karamakil08/Ahrar-Flight-Controller/Schematics SS/Connectors.jpg

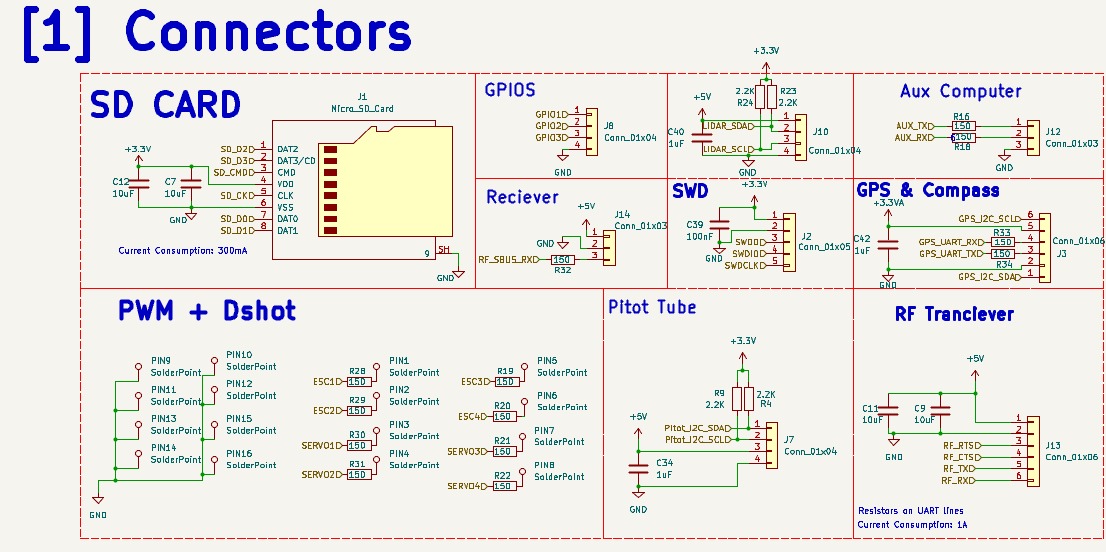
Schematics SS/Connectors.jpg
