karamakil08/Ahrar-Flight-Controller/Schematics SS/MCU.jpg

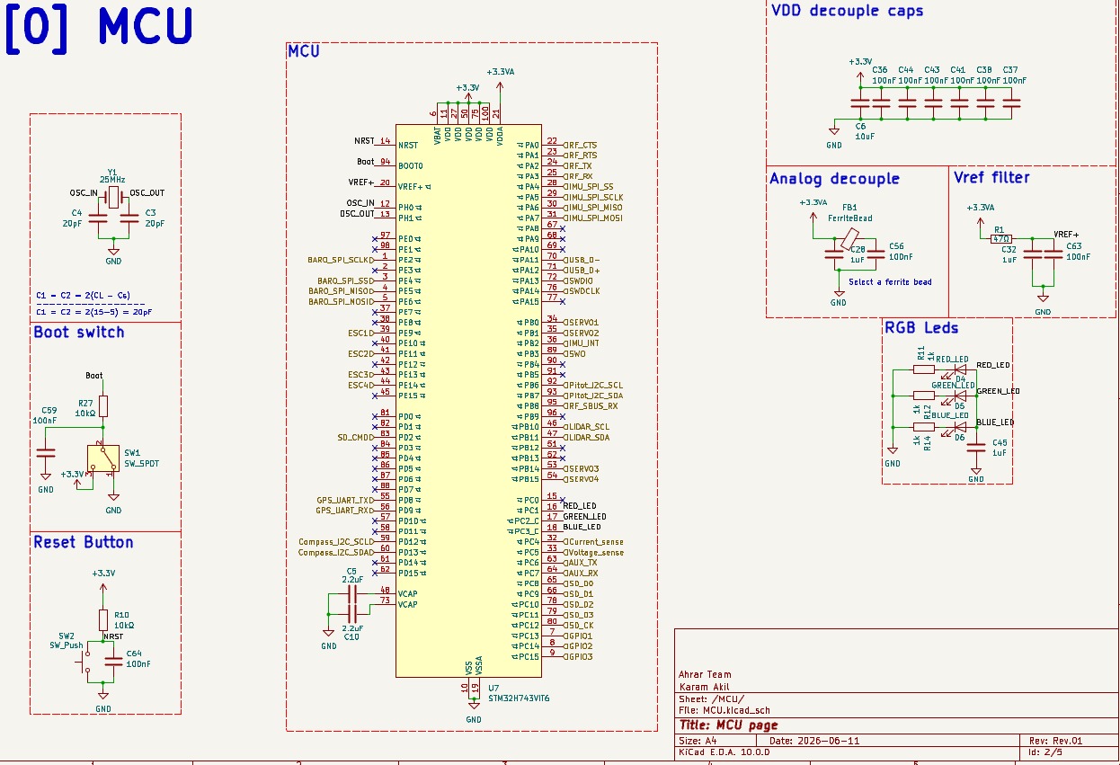
Schematics SS/MCU.jpg
