karamakil08/Ahrar-Flight-Controller/Schematics SS/Power.jpg

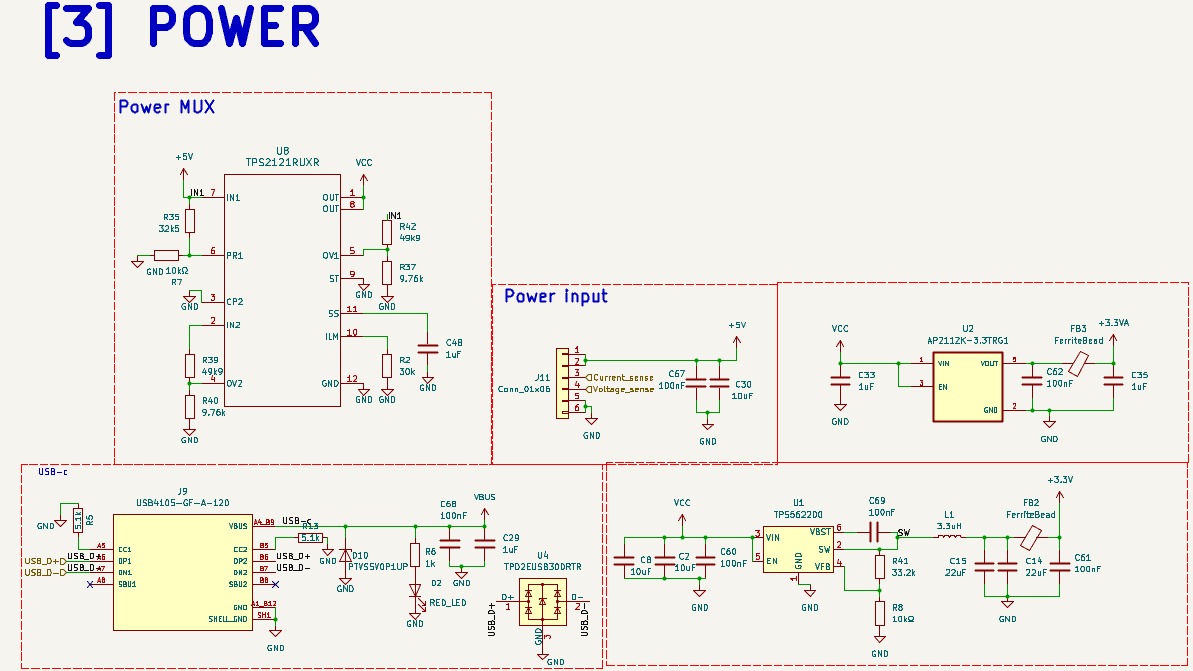
Schematics SS/Power.jpg
