karamakil08/Ahrar-Flight-Controller/Schematics SS/Sensors.jpg

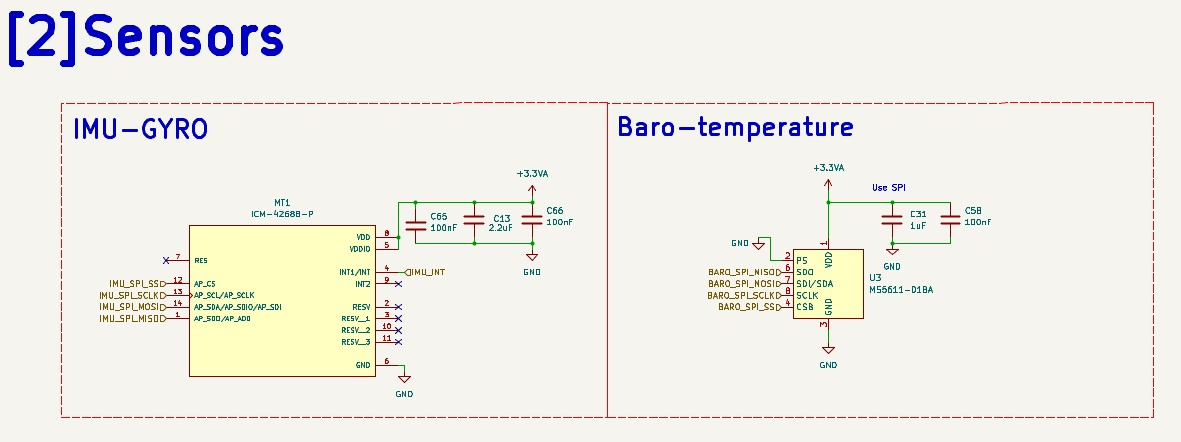
Schematics SS/Sensors.jpg
