karamakil08/Ahrar-Flight-Controller/Ahrar Flight Controller/Ahrar Flight Controller.csv

Reference | Value | Datasheet | Footprint | Qty | DNP | Part Number | Distributer Link | Price
C1,C3 | 6pF | https://cdn.ozdisan.com/public/product/assets/UPY-GP_NP0_16V-to-50V_18.pdf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 | Capacitor_SMD:C_0402_1005Metric | 2 |  | CC0402DRNPO9BN6R0 | https://www.ozdisan.com/p/smt-smd-ve-mlcc-kapasitorler-184/yageo-cc0402drnpo9bn6r0-746529?catSequenceId=184
C4,C16 | 10pF | https://cdn.ozdisan.com/public/product/assets/UPY-GP_NP0_16V-to-50V_18.pdf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 | Capacitor_SMD:C_0603_1608Metric | 2 |  | CL10C100JB81PNC | https://www.ozdisan.com/p/smt-smd-ve-mlcc-kapasitorler-184/samsung-cl10c100jb81pnc-522432?catSequenceId=184
C5,C10,C17,C18,C19,C20,C21,C22,C28,C30,C31 | 2.2uF | https://cdn.ozdisan.com/public/product/assets/SAMSUNG%20MLCC_JAN-2024.pdf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 | Capacitor_SMD:C_0603_1608Metric | 11 |  | CL10B225KP8NNNC | https://www.ozdisan.com/p/smt-smd-ve-mlcc-kapasitorler-184/samsung-cl10b225kp8nnnc-359581?catSequenceId=184
C6,C7,C8,C9,C11,C23,C24,C27,C29 | 22uF | https://cdn.ozdisan.com/public/product/assets/SAMSUNG%20MLCC_JAN-2024.pdf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 | Capacitor_SMD:C_0805_2012Metric | 9 |  | CL21A226KOQNNNE | https://www.ozdisan.com/p/smt-smd-ve-mlcc-kapasitorler-184/samsung-cl21a226koqnnne-399002
C13 | 2.2uF | https://cdn.ozdisan.com/public/product/assets/Murata_GRM_MLCC.pdf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 | Capacitor_SMD:C_0402_1005Metric | 1 |  | GRT155C81A225ME13D | https://www.ozdisan.com/p/smt-smd-ve-mlcc-kapasitorler-184/murata-grt155c81a225me13d-624222
C25,C26 | 100uF | https://cdn.ozdisan.com/public/product/assets/VISHAY-293D%20SERIES.pdf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 | Capacitor_Tantalum_SMD:CP_EIA-6032-20_AVX-F | 2 |  | 293D107X0010C2TE3 | https://www.ozdisan.com/p/tantal-kapasitorler-178/vishay-293d107x0010c2te3-502187
C36,C37,C38,C39,C40,C41,C43,C44,C45,C47,C49,C50,C51,C52,C56,C57,C58,C59,C63,C64,C65,C66,C67,C68,C69,C70,C71,C72,C73,C74,C75 | 100nF | https://cdn.ozdisan.com/public/product/assets/Murata_GRM_MLCC.pdf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 | Capacitor_SMD:C_0402_1005Metric | 31 |  | GRM155R71C104KA88D | https://www.ozdisan.com/p/smt-smd-ve-mlcc-kapasitorler-184/murata-grm155r71c104ka88d-423396
D2 | Green LED | https://cdn.ozdisan.com/public/product/assets/HL-PST-1608U51GC-yeni.PDF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 | LED_SMD:LED_0603_1608Metric | 1 |  | HL-PST-1608U51GC | https://www.ozdisan.com/p/sinyal-ledler-tek-renkli-361/honglitronic-hl-pst-1608u51gc-471660
D3 | ESD321DYAR | https://www.onsemi.com/pdf/datasheet/esd5z2.5t1-d.pdf | Diode_SMD:D_SOD-523 | 1 |  | ESD321DYAR | https://www.mouser.com.tr/en/ProductDetail/Texas-Instruments/ESD321DYAR?qs=rQFj71Wb1eXoYwRMra0IYA%3D%3D
D4 | RED_LED | https://cdn.ozdisan.com/public/product/assets/27-21-R6C-AP1Q2B-3C.PDF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 | LED_SMD:LED_0603_1608Metric | 1 |  | 27-21/R6C-AP1Q2B/3C | https://www.ozdisan.com/p/sinyal-ledler-tek-renkli-361/everlight-27-21-r6c-ap1q2b-3c-602569
D6 | BLUE_LED | https://cdn.ozdisan.com/public/product/assets/HL-PST-1608H203BC-yeni.PDF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 | LED_SMD:LED_0603_1608Metric | 1 |  | HL-PST-1608H203BC | https://www.ozdisan.com/p/sinyal-ledler-tek-renkli-361/honglitronic-hl-pst-1608h203bc-471659
FB1 | FerriteBead | https://www.murata.com/en-us/products/productdata/8796741599262/ENFA0004.pdf | Resistor_SMD:R_0603_1608Metric | 1 |  | BLM18HE601SN1D | https://www.e-komponent.com/blm18he601sn1d-murata-electronics-ferit-bead-ve-cip
J1 | Conn_02x08_Counter_Clockwise | https://cdn.ozdisan.com/public/product/assets/DS1022-REV.pdf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 | Connector_PinHeader_2.54mm:PinHeader_2x08_P2.54mm_Horizontal | 1 |  | DS1022-2X8RF11-B | https://www.ozdisan.com/p/pin-headerlar-293/connfly-ds1022-2x8rf11-b-699898?catSequenceId=293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
J2 | Conn_01x04 | https://www.molex.com/en-us/products/part-detail/22284046?display=pdf | Connector_PinHeader_2.54mm:PinHeader_1x04_P2.54mm_Vertical | 1 |  | 22-28-4046 | https://www.mouser.com.tr/en/ProductDetail/Molex/22-28-4046?qs=GAPJcf4kvdtZsXSzVDpHFw%3D%3D
J3 | Conn_01x06 | https://www.jst-mfg.com/product/pdf/eng/eGH.pdf | Connector_JST:JST_GH_SM06B-GHS-TB_1x06-1MP_P1.25mm_Horizontal | 1 |  | SM06B-GHS-TB | https://www.e-komponent.com/connector-header-sm06b-ghs-tb
J4 | 1040310811 | https://www.molex.com/en-us/products/part-detail-pdf/1040310811?display=pdf | Molex 1040310811:104031-0811_MOL | 1 |  | MOLEX-1040310811 | https://www.mouser.com.tr/en/ProductDetail/Molex/104031-0811?qs=udsGRKD4nA3Tvy7wqky%252BuA%3D%3D
J9 | USB4105-GF-A-120 | https://www.mouser.com/catalog/specsheets/Global_Connector_Technology_usb4105.pdf | USB4105-GF-A-120:GCT_USB4105-GF-A-120 | 1 |  | USB4105-GF-A-120 | https://www.mouser.com.tr/en/ProductDetail/GCT/USB4105-GF-A-120?qs=QNEnbhJQKva%252Bjxw%2FpEjDhQ%3D%3D
J10,J15,J16 | Conn_01x04 | https://www.mouser.com.tr/datasheet/3/1070/1/eGH.pdf | Connector_JST:JST_GH_SM04B-GHS-TB_1x04-1MP_P1.25mm_Horizontal | 3 |  | SM04B-GHS-TB(LF)(SN) | https://www.mouser.com.tr/en/ProductDetail/JST-Commercial/SM04B-GHS-TBLFSN?qs=QpmGXVUTftGayLYZQBIuZw%3D%3D
J13,J17 | Conn_01x06 | https://www.molex.com/en-us/products/part-detail-pdf/5024940670?display=pdf | Connector_Molex:Molex_CLIK-Mate_502494-0670_1x06-1MP_P2.00mm_Horizontal | 2 |  | 502494-0670 | https://www.mouser.com.tr/en/ProductDetail/Molex/502494-0670?qs=zRnNmUVysJflJNy8qKc1Eg%3D%3D
J14,J18 | Conn_01x03 | https://www.mouser.com.tr/datasheet/3/1070/1/eGH.pdf | Connector_JST:JST_GH_SM03B-GHS-TB_1x03-1MP_P1.25mm_Horizontal | 2 |  | SM03B-GHS-TB(LF)(SN) | https://www.mouser.com.tr/en/ProductDetail/JST-Commercial/SM03B-GHS-TBLFSN?qs=QpmGXVUTftFwNjadUkntHA%3D%3D
MT1 | ICM-42688-P | https://product.tdk.com/system/files/dam/doc/product/sensor/mortion-inertial/imu/data_sheet/ds-000347-icm-42688-p-v1.6.pdf | ICM_42688_P:LGA14_2P5X3X0P91_TDK-L | 1 |  | ICM-42688-P | https://www.mouser.com.tr/en/ProductDetail/TDK-InvenSense/ICM-42688-P?qs=OlC7AqGiEDk8QrNAV728zw%3D%3D
MT2 | ICM-45686 | https://www.mouser.com/catalog/specsheets/TDK_DS_000577_ICM_45686.pdf | ICM_42688_P:LGA14_2P5X3X0P91_TDK-L | 1 |  | ICM-45686 | https://www.mouser.com.tr/en/ProductDetail/TDK-InvenSense/ICM-45686?qs=vvQtp7zwQdPk96IFOwypvQ%3D%3D
R2,R23 | 30k | https://cdn.ozdisan.com/public/product/assets/Pansonic_Anti-Sulfurated%20Thick%20Film%20Chip%20Resistors_ERJ-S%2CS02%2CS03%2CS06%2CS08%2CS14%2CS12%2CS1D%2CS1T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 | Resistor_SMD:R_0402_1005Metric | 2 |  | ERJ2RKF3002X | https://www.ozdisan.com/p/smt-smd-ve-cip-direncler-194/panasoniceurope-erj2rkf3002x-614685?s=ERJ2RKF3002X
R3,R12,R17,R24,R25,R26,R27,R38,R43,R44,R47,R48,R49,R52,R57,R59,R60,R64,R65,R66,R73,R74,R75,R76,R79,R80,R81,R82 | 20 | https://cdn.ozdisan.com/public/product/assets/Pansonic_Anti-Sulfurated%20Thick%20Film%20Chip%20Resistors_ERJ-S%2CS02%2CS03%2CS06%2CS08%2CS14%2CS12%2CS1D%2CS1T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 | Resistor_SMD:R_0402_1005Metric | 28 |  | ERJ2GEJ200X | https://www.ozdisan.com/p/smt-smd-ve-cip-direncler-194/panasoniceurope-erj2gej200x-1182780?catSequenceId=194
R4,R9 | 4.7 | https://cdn.ozdisan.com/public/product/assets/AECQ200CQ_ROYALOHM.pdf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 | Resistor_SMD:R_0402_1005Metric | 2 |  | CQ02WGJ047JTCE | https://www.ozdisan.com/p/smt-smd-ve-cip-direncler-194/royalohm-cq02wgj047jtce-587859?catSequenceId=194
R5,R13 | 5.1k | https://cdn.ozdisan.com/public/product/assets/Pansonic_Anti-Sulfurated%20Thick%20Film%20Chip%20Resistors_ERJ-S%2CS02%2CS03%2CS06%2CS08%2CS14%2CS12%2CS1D%2CS1T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 | Resistor_SMD:R_0402_1005Metric | 2 |  | ERJ2RKF5101X | https://www.ozdisan.com/p/smt-smd-ve-cip-direncler-194/panasoniceurope-erj2rkf5101x-1046672
R6,R14,R83 | 1k | https://cdn.ozdisan.com/public/product/assets/general_royalohm.pdf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 | Resistor_SMD:R_0402_1005Metric | 3 |  | 0402WGJ0102TCE | https://www.ozdisan.com/p/smt-smd-ve-cip-direncler-194/royalohm-0402wgj0102tce-431887?catSequenceId=194
R10,R15,R36,R41,R45,R46,R50,R51,R53,R54,R55 | 10kΩ | http://cdn.ozdisan.com/public/product/assets/Pansonic_Anti-Sulfurated%20Thick%20Film%20Chip%20Resistors_ERJ-S%2CS02%2CS03%2CS06%2CS08%2CS14%2CS12%2CS1D%2CS1T%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 | Resistor_SMD:R_0402_1005Metric | 11 |  | ERJ2RKF1002X | https://www.ozdisan.com/p/smt-smd-ve-cip-direncler-194/panasoniceurope-erj2rkf1002x-609851?catSequenceId=194
R16,R18,R19,R20,R21,R22,R28,R29,R30,R31,R32,R33,R34,R56,R58,R61,R62,R63,R77,R78 | 220 | https://cdn.ozdisan.com/public/product/assets/Pansonic_Anti-Sulfurated%20Thick%20Film%20Chip%20Resistors_ERJ-S%2CS02%2CS03%2CS06%2CS08%2CS14%2CS12%2CS1D%2CS1T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 | Resistor_SMD:R_0402_1005Metric | 20 |  | ERJ2RKF2200X | https://www.ozdisan.com/p/smt-smd-ve-cip-direncler-194/panasoniceurope-erj2rkf2200x-621350?catSequenceId=194
R35 | 32k5 | https://cdn.ozdisan.com/public/product/assets/general_royalohm.pdf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 | Resistor_SMD:R_0402_1005Metric | 1 |  | 0402WGF3242TCE | https://www.ozdisan.com/p/smt-smd-ve-cip-direncler-194/royalohm-0402wgf3242tce-506352
R37,R40 | 9.76k | https://cdn.ozdisan.com/public/product/assets/general_royalohm.pdf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 | Resistor_SMD:R_0402_1005Metric | 2 |  | 0402WGF9761TCE | https://www.ozdisan.com/p/smt-smd-ve-cip-direncler-194/royalohm-0402wgf9761tce-506310
R39,R42 | 49k9 | https://cdn.ozdisan.com/public/product/assets/Pansonic_Anti-Sulfurated%20Thick%20Film%20Chip%20Resistors_ERJ-S%2CS02%2CS03%2CS06%2CS08%2CS14%2CS12%2CS1D%2CS1T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 | Resistor_SMD:R_0402_1005Metric | 2 |  | ERJ2RKF4992X | https://www.ozdisan.com/p/smt-smd-ve-cip-direncler-194/panasoniceurope-erj2rkf4992x-621356
R67,R68,R69,R70,R71,R72 | 4.7k | https://cdn.ozdisan.com/public/product/assets/Pansonic_Anti-Sulfurated%20Thick%20Film%20Chip%20Resistors_ERJ-S%2CS02%2CS03%2CS06%2CS08%2CS14%2CS12%2CS1D%2CS1T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 | Resistor_SMD:R_0402_1005Metric | 6 |  | ERJ2RKF4701X | https://www.ozdisan.com/p/smt-smd-ve-cip-direncler-194/panasoniceurope-erj2rkf4701x-494668?catSequenceId=194
SW1 | SW_SPDT | https://cdn.ozdisan.com/public/product/assets/L-KLS7-MSK-12C03.pdf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 | Button_Switch_SMD:SW_SPDT_CK_JS102011SAQN | 1 |  | L-KLS7-MSK-12C03 | https://www.ozdisan.com/p/surgulu-sivicler-495/kls-electronic-l-kls7-msk-12c03-518011
SW2 | SW_Push | https://cdn.ozdisan.com/public/product/assets/PTS810-seri-CK.pdf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 | Button_Switch_SMD:SW_SPST_PTS810 | 1 |  | PTS810 SJM 250 SMTR LFS | https://www.ozdisan.com/p/tact-sivicler-485/littelfuse-ck-pts810-sjm-250-smtr-lfs-478609?catSequenceId=485
U2 | TLV1117-33 | http://www.ti.com/lit/ds/symlink/tlv1117.pdf | Package_SON:WSON-8-1EP_4x4mm_P0.8mm_EP2.2x3mm | 1 |  | TLV1117-33IDRJR | https://www.mouser.com.tr/en/ProductDetail/Texas-Instruments/TLV1117-33IDRJR?qs=p6lVfQR1GSoDjhibbRLWxw%3D%3D
U3 | MS5611-01BA | https://www.te.com/commerce/DocumentDelivery/DDEController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 | Package_LGA:LGA-8_3x5mm_P1.25mm | 1 |  | MS561101BA03-50 | https://www.mouser.com.tr/en/ProductDetail/TE-Connectivity-Measurement-Specialties/MS561101BA03-50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
U4 | TPD2EUSB30DRTR | http://www.ti.com/lit/ds/symlink/tpd2eusb30a.pdf | Package_TO_SOT_SMD:Texas_DRT-3 | 1 |  | TPD2EUSB30DRTR | https://www.mouser.com.tr/en/ProductDetail/Texas-Instruments/TPD2EUSB30DRTR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
U5 | BMP581 | https://www.bosch-sensortec.com/media/boschsensortec/downloads/datasheets/bst-bmp581-ds004.pdf | BMP581:BMP581 | 1 |  | BMP581 | https://www.mouser.com.tr/en/ProductDetail/Bosch-Sensortec/BMP581?qs=Li%252BoUPsLEntPL9tlFmcgXg%3D%3D
U7 | STM32H743VIT6 | https://www.st.com/resource/en/datasheet/stm32h743vi.pdf | Package_QFP:LQFP-100_14x14mm_P0.5mm | 1 |  | STM32H743VIT6 | https://www.mouser.com.tr/en/ProductDetail/STMicroelectronics/STM32H743VIT6?qs=FNcb6ahWXRw0Me5k2ZHgWw%3D%3D
U8 | TPS2121 | https://www.ti.com/lit/gpn/tps2121 | footprints.ugly:RUX0012A | 1 |  | TPS2121RUXR | https://www.mouser.com.tr/en/ProductDetail/Texas-Instruments/TPS2121RUXR?qs=qSfuJ%252Bfl%2Fd7dCYiVnUfngQ%3D%3D
Y1 | 25MHz | https://cdn.ozdisan.com/public/product/assets/ECS_ECX-2236Q.pdf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 | Oscillator:Oscillator_SMD_Abracon_ASDMB-4Pin_2.5x2.0mm | 1 |  | ECS-250-10-36Q-ES-TR | https://www.ozdisan.com/p/kristaller-508/ecs-ecs-250-10-36q-es-tr-710745?catSequenceId=508
Y2 | 32.768KHz | https://cdn.ozdisan.com/public/product/assets/RT2012_SERIES.pdf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 | Crystal:Crystal_SMD_2012-2Pin_2.0x1.2mm_HandSoldering | 1 |  | RT2012-32.768-7-TR | https://www.ozdisan.com/p/kristaller-508/raltron-rt2012-32-768-7-tr-994638?catSequenceId=508
