karamakil08/Ahrar-Flight-Controller/Ahrar Flight Controller/Footprints and 3D models/3D models/USB4105-GF-A-120.step

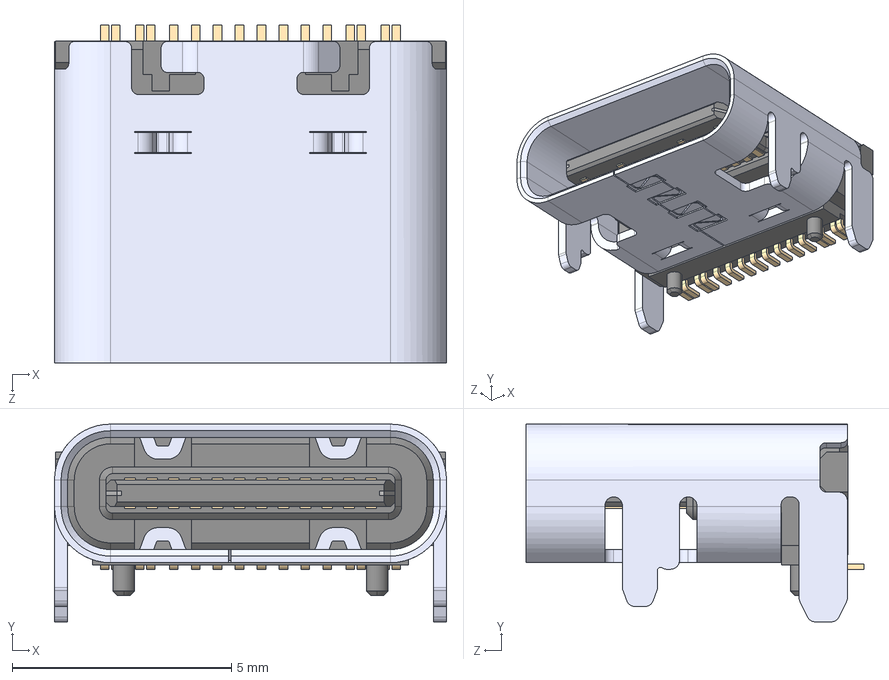
[picture p5: CAD file, 2026-08-06]
Ahrar Flight Controller/Footprints and 3D models/3D models/USB4105-GF-A-120.step
8.94 x 4.51 x 7.71 mm
