karamakil08/Ahrar-Flight-Controller/Ahrar Flight Controller/Footprints and 3D models/3D models/HSE_Oscillator.STEP

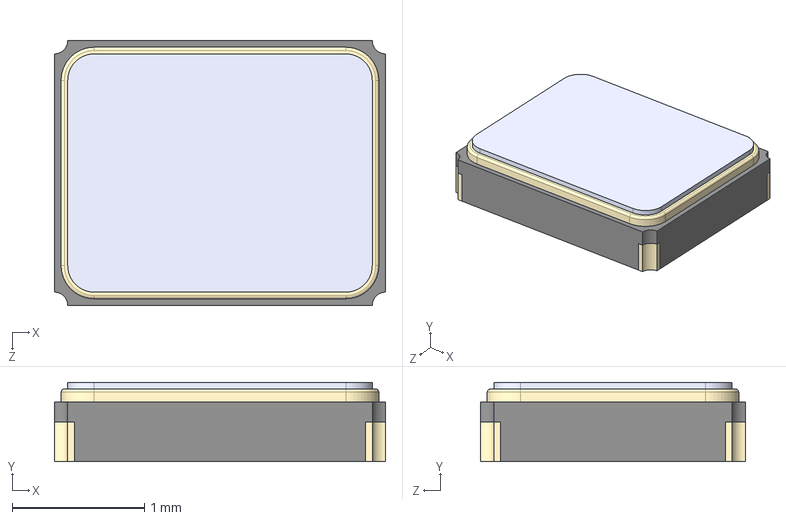
[picture p6: CAD file, 2026-08-06]
Ahrar Flight Controller/Footprints and 3D models/3D models/HSE_Oscillator.STEP
2.50 x 0.6 x 2.00 mm
