karamakil08/Ahrar-Flight-Controller/Ahrar Flight Controller/Footprints and 3D models/3D models/BMP581.step

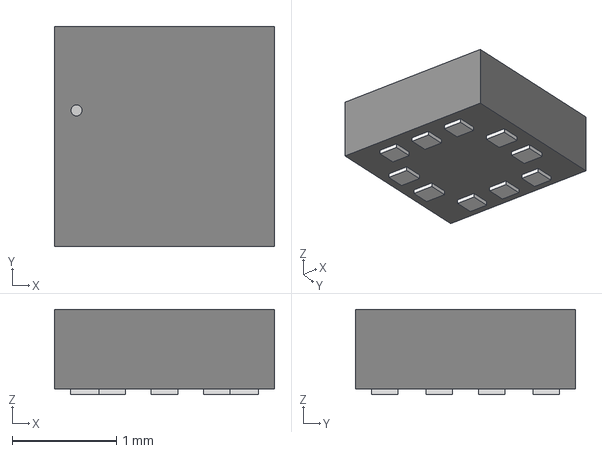
[picture p7: CAD file, 2026-08-06]
Ahrar Flight Controller/Footprints and 3D models/3D models/BMP581.step
2.11 x 2.11 x 0.815 mm
