karamakil08/Ahrar-Flight-Controller/Ahrar Flight Controller/Footprints and 3D models/3D models/LSE_Oscillator.STEP

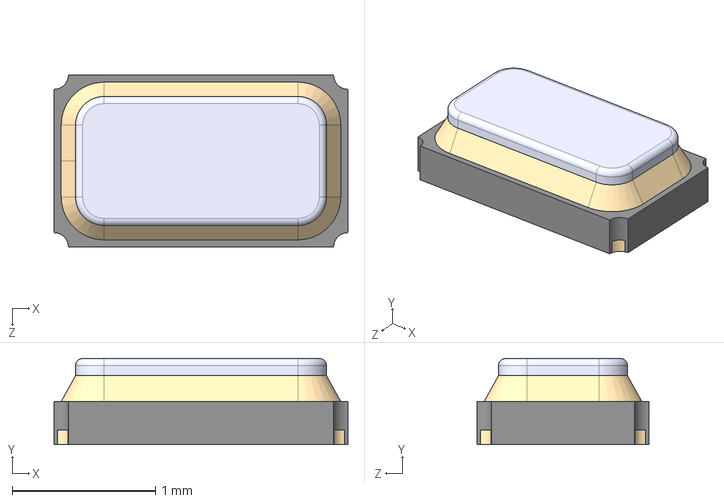
[picture p8: CAD file, 2026-08-06]
Ahrar Flight Controller/Footprints and 3D models/3D models/LSE_Oscillator.STEP
2.05 x 0.6 x 1.20 mm
