karamakil08/Ahrar-Flight-Controller/Ahrar Flight Controller/Footprints and 3D models/3D models/SD-card socket.stp

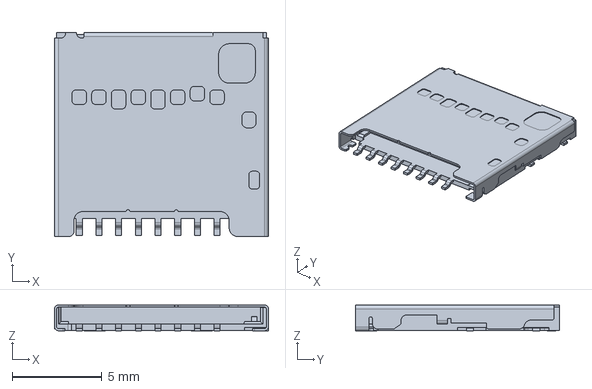
[picture p9: CAD file, 2026-08-06]
Ahrar Flight Controller/Footprints and 3D models/3D models/SD-card socket.stp
11.9 x 11.4 x 1.45 mm
