karamakil08/Ahrar-Flight-Controller/Ahrar Flight Controller/Footprints and 3D models/3D models/TPS2121RUXR.STEP

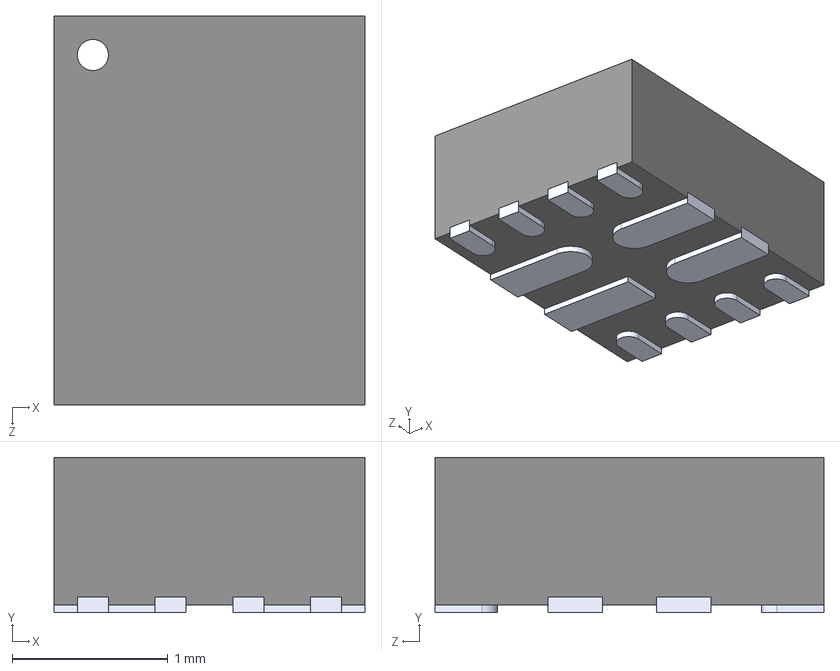
[picture p10: CAD file, 2026-08-06]
Ahrar Flight Controller/Footprints and 3D models/3D models/TPS2121RUXR.STEP
2.00 x 1.00 x 2.50 mm
