karamakil08/Ahrar-Flight-Controller/Ahrar Flight Controller/Footprints and 3D models/3D models/ICM-45686.STEP

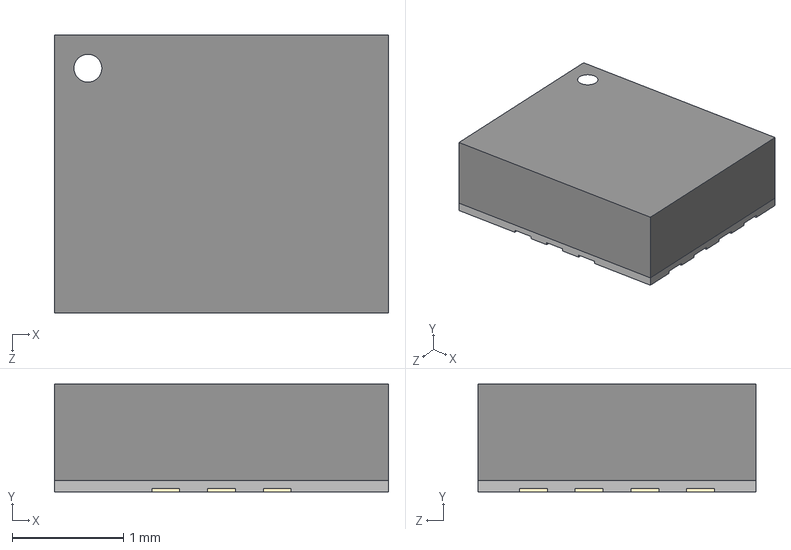
[picture p11: CAD file, 2026-08-06]
Ahrar Flight Controller/Footprints and 3D models/3D models/ICM-45686.STEP
3.00 x 0.97 x 2.50 mm
