karamakil08/Ahrar-Flight-Controller/Ahrar Flight Controller/Footprints and 3D models/3D models/TLV1117-33.stp

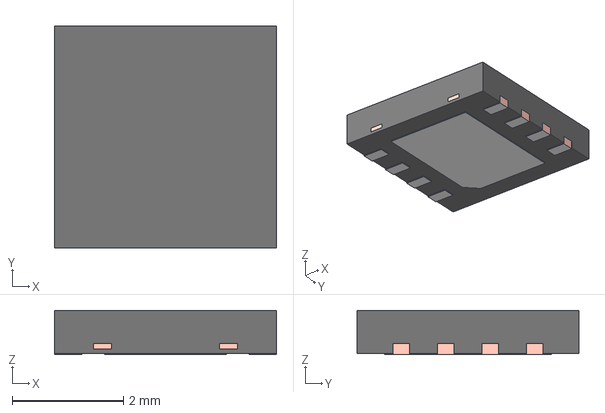
[picture p12: CAD file, 2026-08-06]
Ahrar Flight Controller/Footprints and 3D models/3D models/TLV1117-33.stp
4.00 x 4.00 x 0.8 mm
FRAME
