karamakil08/Ahrar-Flight-Controller/Ahrar Flight Controller/Footprints and 3D models/3D models/SPDT switch.STEP

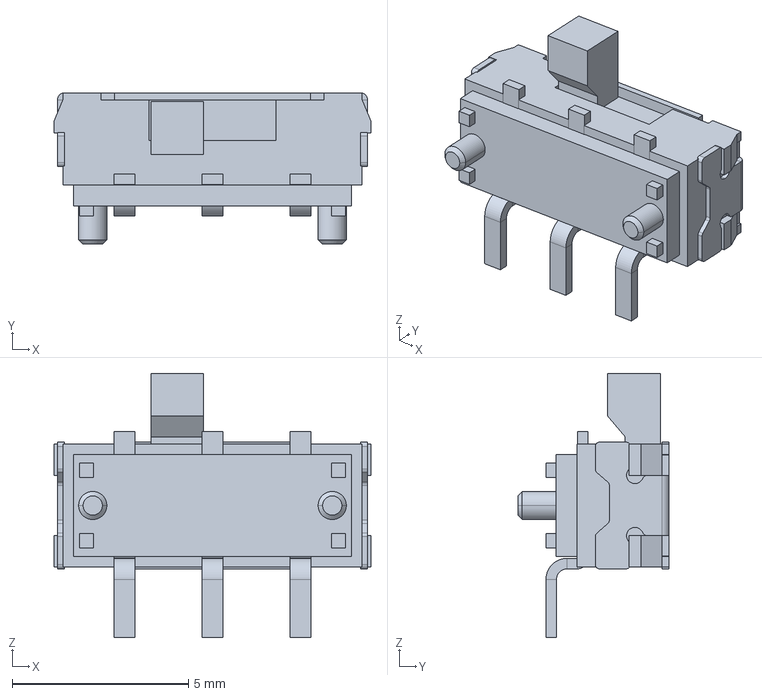
[picture p13: CAD file, 2026-08-06]
Ahrar Flight Controller/Footprints and 3D models/3D models/SPDT switch.STEP
9.00 x 4.30 x 7.50 mm
