karamakil08/Ahrar-Flight-Controller/Ahrar Flight Controller/Footprints and 3D models/3D models/5024940670.stp

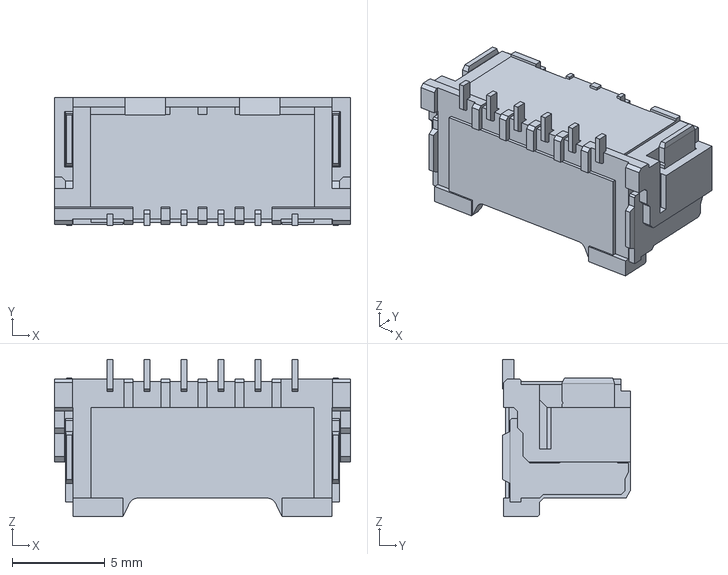
[picture p14: CAD file, 2026-08-06]
Ahrar Flight Controller/Footprints and 3D models/3D models/5024940670.stp
16.0 x 6.90 x 8.50 mm
