karamakil08/Ahrar-Flight-Controller/Ahrar Flight Controller/Ahrar Flight Controller.kicad_pcb

## KiCad design Ahrar Flight Controller/Ahrar Flight Controller.kicad_pcb (2026-08-07)

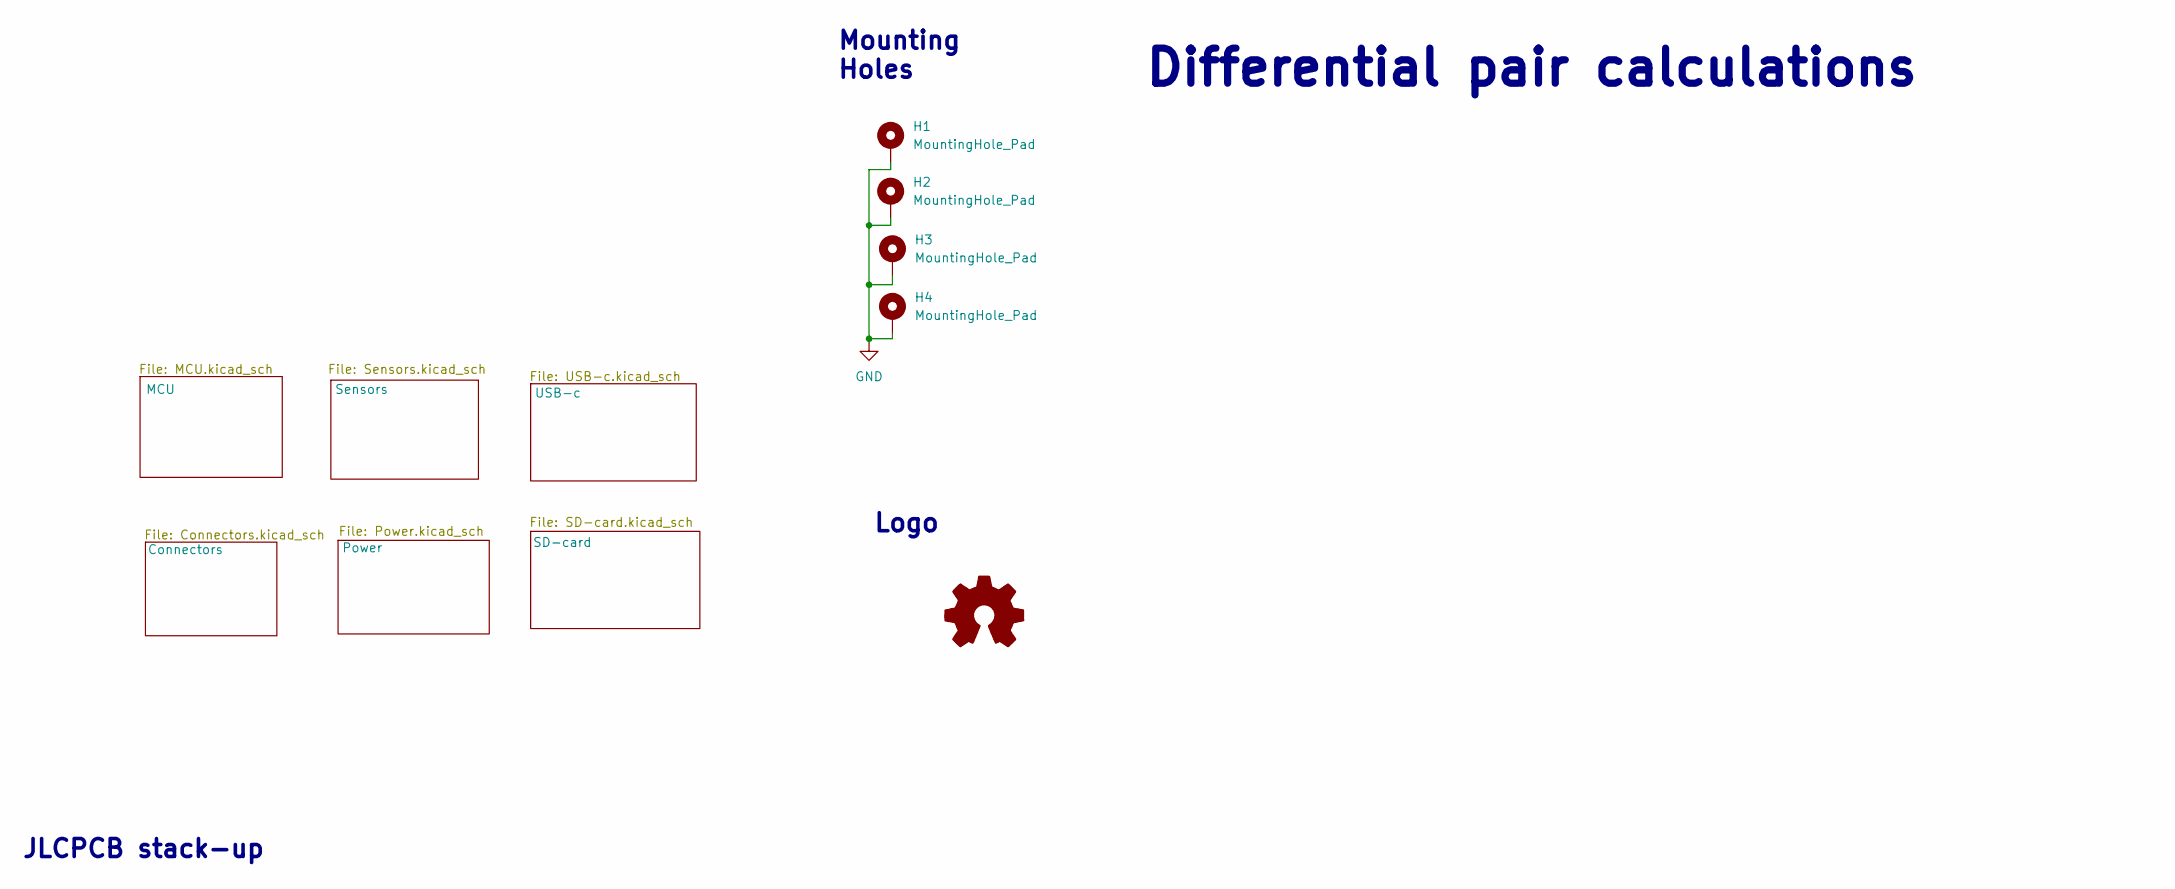
[picture p15: schematic Ahrar Flight Controller.kicad_sch]

Parts:
H1, H2, H3, H4: MountingHole_Pad; MountingHole_2.2mm_M2_Pad_Via
Logo1: Hananou logo

Connections:
GND: H1.1 (1_1), H2.1 (1_1), H3.1 (1_1), H4.1 (1_1); also elsewhere on the board

Notes on the sheet:
Differential pair calculations
Mounting Holes
JLCPCB stack-up
Logo

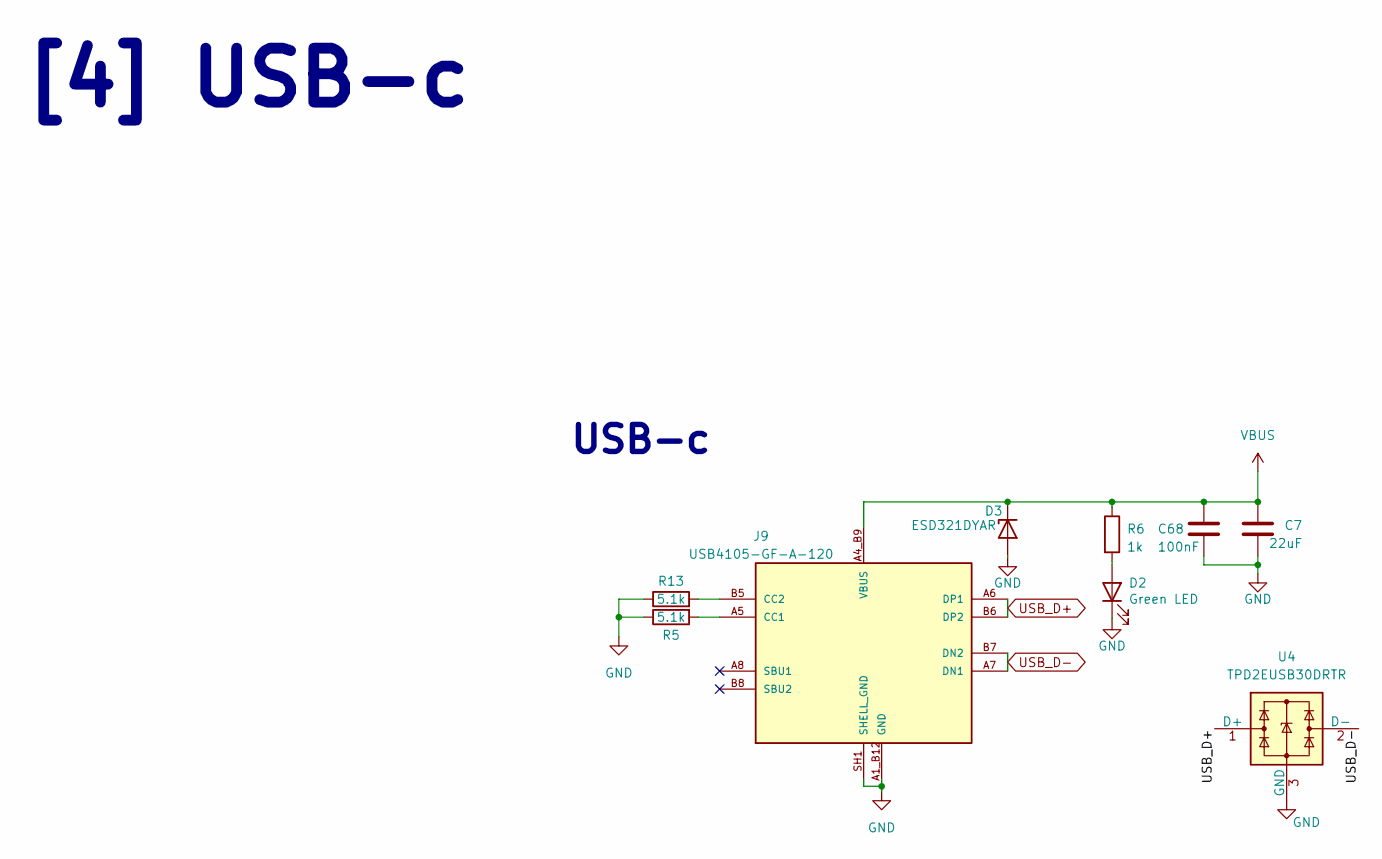
[picture p16: schematic USB-c.kicad_sch, USB-c]

Parts:
C7: 22uF; C_0805_2012Metric; Part Number CL21A226KOQNNNE
C68: 100nF; C_0402_1005Metric; Part Number GRM155R71C104KA88D
D2: Green LED; LED_0603_1608Metric; Part Number HL-PST-1608U51GC
D3: ESD321DYAR; D_SOD-523; Part Number ESD321DYAR
J9: USB4105-GF-A-120; GCT_USB4105-GF-A-120; Part Number USB4105-GF-A-120
R5, R13: 5.1k; R_0402_1005Metric; Part Number ERJ2RKF5101X
R6: 1k; R_0402_1005Metric; Part Number 0402WGJ0102TCE
U4: TPD2EUSB30DRTR; Texas_DRT-3

Connections:
GND: C7.2, C68.2, D2.1 (K), D3.2 (A), J9.A1_B12 (GND), J9.B1_A12 (GND), J9.SH1 (SHELL_GND), J9.SH2 (SHELL_GND), J9.SH3 (SHELL_GND), J9.SH4 (SHELL_GND), R5.1, R13.1, U4.3 (GND); also elsewhere on the board
unnamed: D2.2 (A), R6.2
unnamed: J9.A5 (CC1), R5.2
unnamed: J9.B5 (CC2), R13.2
USB_D+: J9.A6 (DP1), J9.B6 (DP2), U4.1 (D+); also elsewhere on the board
USB_D-: J9.A7 (DN1), J9.B7 (DN2), U4.2 (D-); also elsewhere on the board
VBUS: C7.1, C68.1, D3.1 (K), J9.A4_B9 (VBUS), J9.B4_A9 (VBUS), R6.1

Notes on the sheet:
USB-c
[4] USB-c

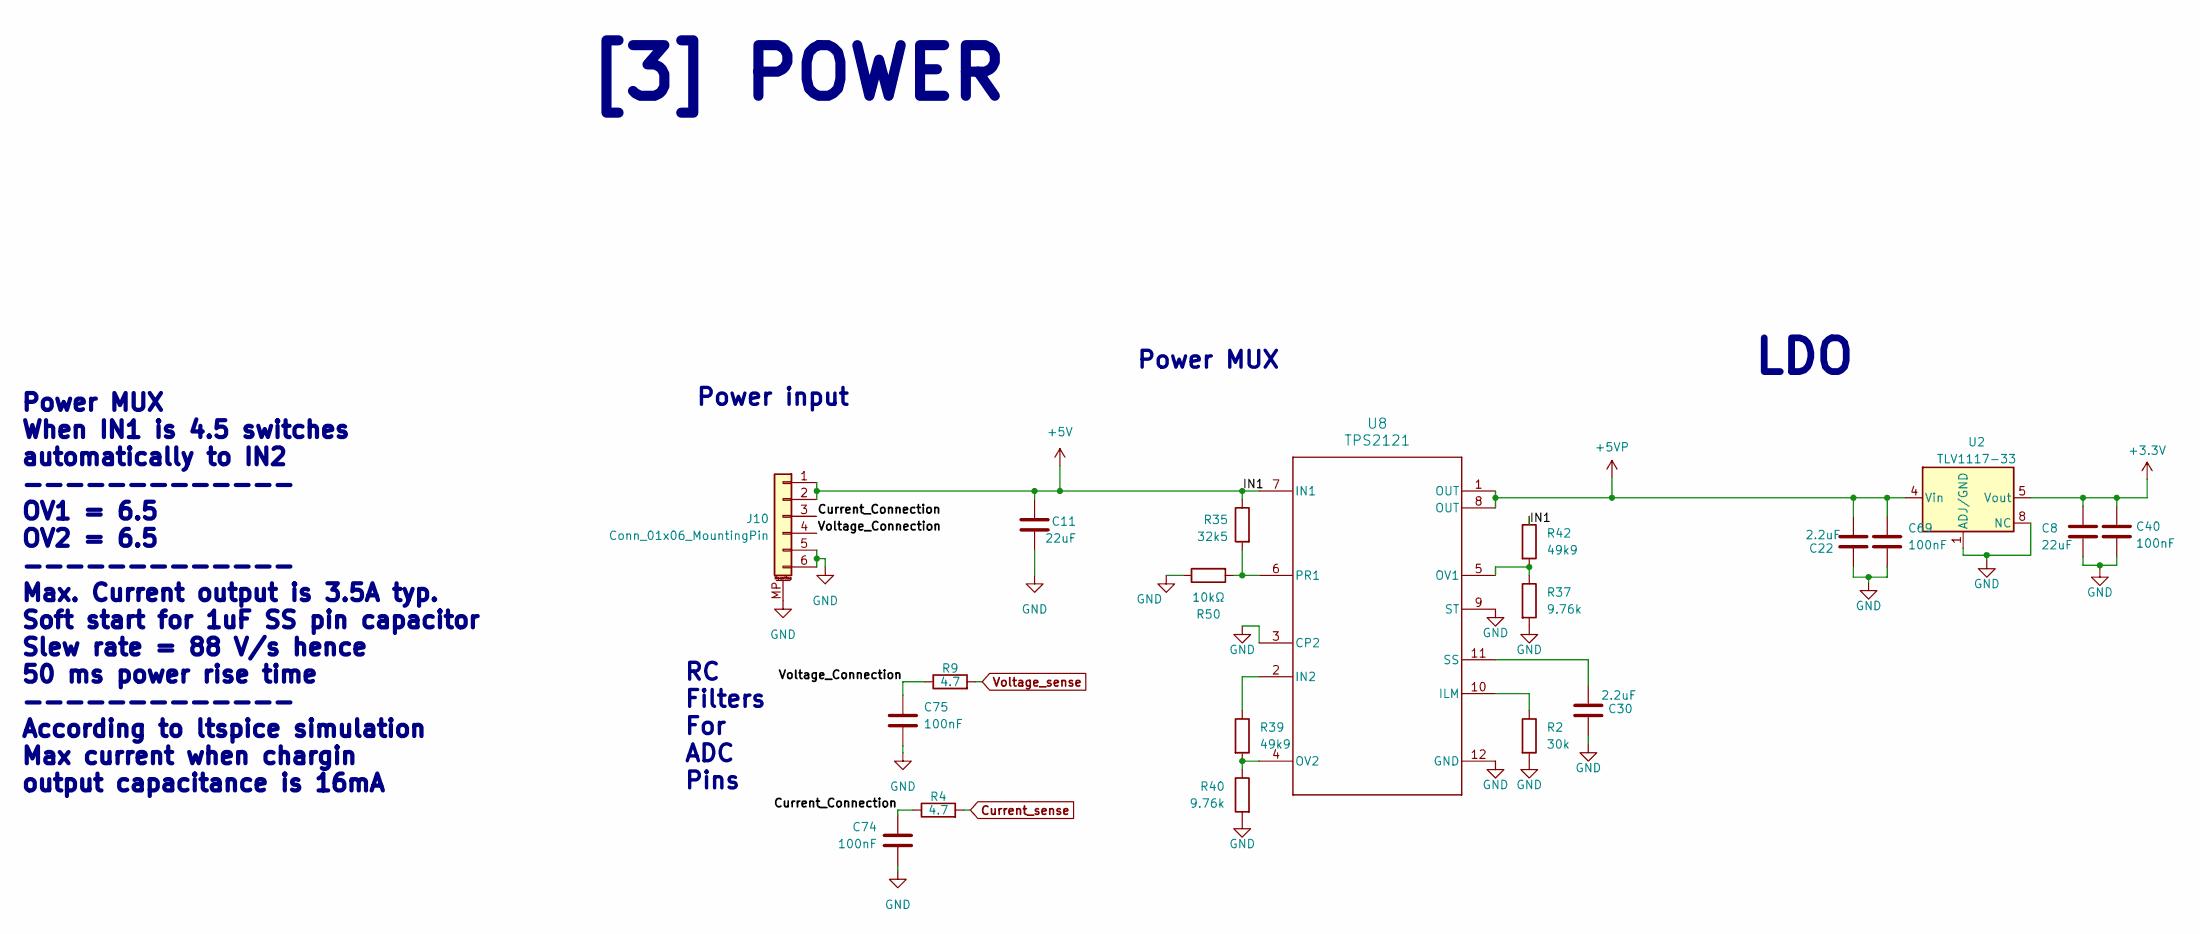
[picture p17: schematic Power.kicad_sch]

Parts:
C8, C11: 22uF; C_0805_2012Metric; Part Number CL21A226KOQNNNE
C22, C30: 2.2uF; C_0603_1608Metric; Part Number CL10B225KP8NNNC
C40, C69, C74, C75: 100nF; C_0402_1005Metric; Part Number GRM155R71C104KA88D
J10: Conn_01x06_MountingPin; Molex_CLIK-Mate_502494-0670_1x06-1MP_P2.00mm_Horizontal; Part Number 502494-0670
R2: 30k; R_0402_1005Metric; Part Number ERJ2RKF3002X
R4, R9: 4.7; R_0402_1005Metric; Part Number CQ02WGJ047JTCE
R35: 32k5; R_0402_1005Metric; Part Number 0402WGF3242TCE
R37, R40: 9.76k; R_0402_1005Metric; Part Number 0402WGF9761TCE
R39, R42: 49k9; R_0402_1005Metric; Part Number ERJ2RKF4992X
R50: 10kΩ; R_0402_1005Metric; Part Number ERJ2RKF1002X
U2: TLV1117-33; WSON-8-1EP_4x4mm_P0.8mm_EP2.2x3mm; Part Number TLV1117-33IDRJR
U8: TPS2121; RUX0012A; Part Number TPS2121RUXR

Connections:
+3.3V: C8.1, C40.1, U2.5 (Vout), U2.6 (Vout), U2.7 (Vout); also elsewhere on the board
+5V: C11.1, J10.1, J10.2, R35.1, R42.1, U8.7 (IN1); also elsewhere on the board
+5VP: C22.1, C69.1, U2.2 (Vin), U2.3 (Vin), U2.4 (Vin), U8.1 (OUT), U8.8 (OUT); also elsewhere on the board
/Power/Current_Connection: C74.1, J10.3, R4.1
/Power/Voltage_Connection: C75.1, J10.4, R9.1
Current_sense: R4.2; also elsewhere on the board
GND: C8.2, C11.2, C22.2, C30.2, C40.2, C69.2, C74.2, C75.2, J10.5, J10.6, J10.MP (MountPin), R2.2, R37.2, R40.2, R50.1, U2.1 (ADJ/GND), U2.8 (NC), U2.9 (PAD), U8.3 (CP2), U8.9 (ST), U8.12 (GND); also elsewhere on the board
unnamed: R2.1, U8.10 (ILM)
unnamed: R39.1, U8.2 (IN2)
unnamed: R37.1, R42.2, U8.5 (OV1)
unnamed: R39.2, R40.1, U8.4 (OV2)
unnamed: R35.2, R50.2, U8.6 (PR1)
unnamed: C30.1, U8.11 (SS)
Voltage_sense: R9.2; also elsewhere on the board

Notes on the sheet:
Power MUX
LDO
RC Filters For ADC Pins
[3] POWER
Power MUX When IN1 is 4.5 switches automatically to IN2 ------------- OV1 = 6.5 OV2 = 6.5 ------------- Max. Current output is 3.5A typ. Soft start for 1uF SS pin capacitor Slew rate = 88 V/s hence 50 ms power rise time ------------- According to ltspice simulation Max current when chargin output c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
Power input

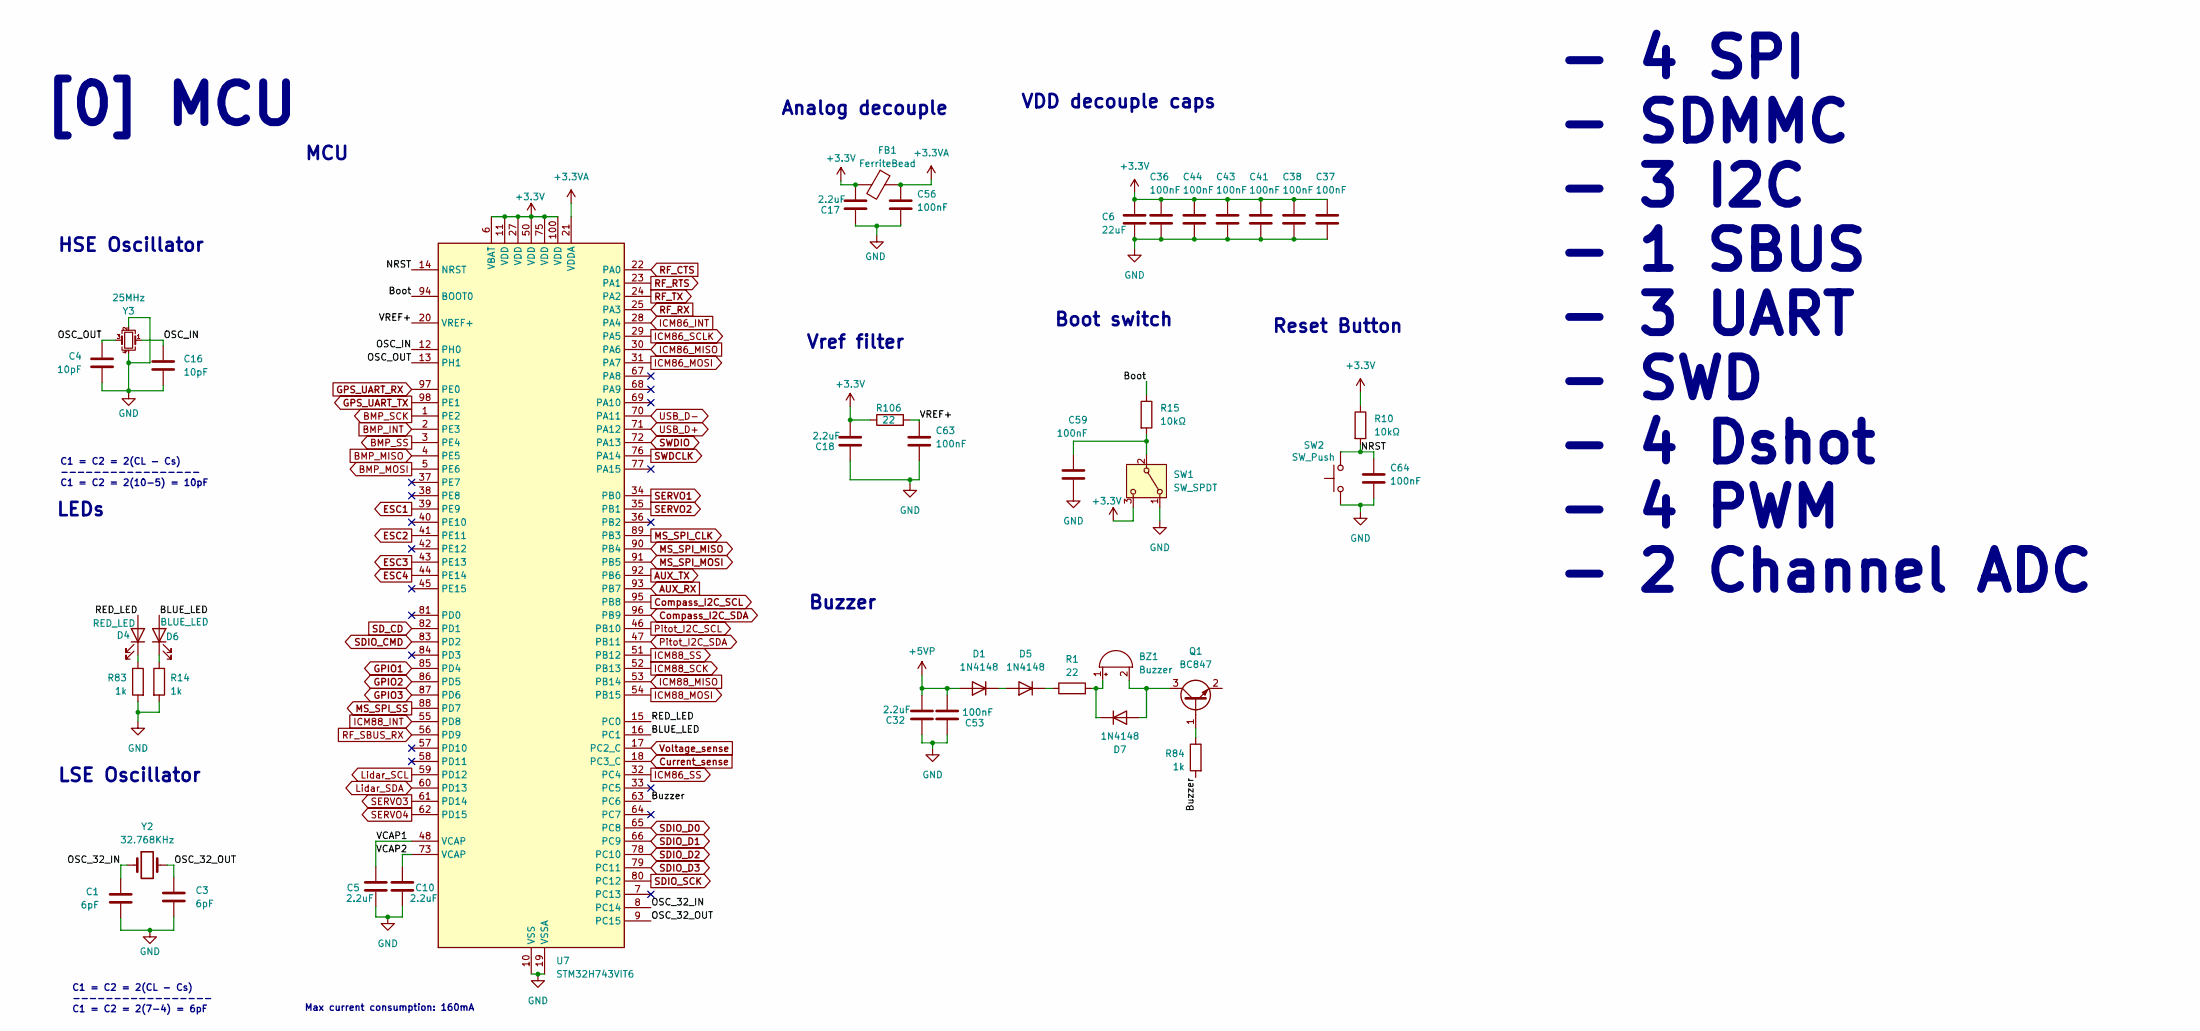
[picture p18: schematic MCU.kicad_sch, MCU page]

Parts:
BZ1: Buzzer; Buzzer_typeshit; Part Number L-KLS3-SMT-3020-3V
C1, C3: 6pF; C_0402_1005Metric; Part Number CC0402DRNPO9BN6R0
C4, C16: 10pF; C_0603_1608Metric; Part Number CL10C100JB81PNC
C5, C10, C17, C18, C32: 2.2uF; C_0603_1608Metric; Part Number CL10B225KP8NNNC
C6: 22uF; C_0805_2012Metric; Part Number CL21A226KOQNNNE
C36, C37, C38, C41, C43, C44, C53, C56, C59, C63, C64: 100nF; C_0402_1005Metric; Part Number GRM155R71C104KA88D
D1, D5, D7: 1N4148; D_SOD-523; Part Number 1N4148WT
D4: RED_LED; LED_0603_1608Metric; Part Number 27-21/R6C-AP1Q2B/3C
D6: BLUE_LED; LED_0603_1608Metric; Part Number HL-PST-1608H203BC
FB1: FerriteBead; R_0603_1608Metric; Part Number BLM18HE601SN1D
Q1: BC847; SOT-23
R1: 22; R_0603_1608Metric; Part Number ERJPA3J220V
R10, R15: 10kΩ; R_0402_1005Metric; Part Number ERJ2RKF1002X
R14, R83, R84: 1k; R_0402_1005Metric; Part Number 0402WGJ0102TCE
R106: 22; R_0402_1005Metric; Part Number CQ02WGF220JTCE
SW1: SW_SPDT; SW_SPDT_CK_JS102011SAQN; Part Number L-KLS7-MSK-12C03
SW2: SW_Push; SW_SPST_PTS810; Part Number PTS810 SJM 250 SMTR LFS
U7: STM32H743VIT6; LQFP-100_14x14mm_P0.5mm; Part Number STM32H743VIT6
Y2: 32.768KHz; Crystal_SMD_2012-2Pin_2.0x1.2mm; Part Number RT2012-32.768-7-TR
Y3: 25MHz; Oscillator_SMD_Abracon_ASDMB-4Pin_2.5x2.0mm; Part Number ECS-250-10-36Q-ES-TR

Connections:
+3.3V: C6.1, C17.1, C18.1, C36.1, C37.1, C38.1, C41.1, C43.1, C44.1, FB1.2, R10.1, R106.1, SW1.3 (C), U7.6 (VBAT), U7.11 (VDD), U7.27 (VDD), U7.50 (VDD), U7.75 (VDD), U7.100 (VDD); also elsewhere on the board
+3.3VA: C56.1, FB1.1, U7.21 (VDDA)
+5VP: C32.1, C53.1, D1.2 (A); also elsewhere on the board
/MCU/BLUE_LED: D6.2 (A), U7.16 (PC1)
/MCU/Boot: R15.1, U7.94 (BOOT0)
/MCU/Buzzer: R84.2, U7.63 (PC6)
/MCU/NRST: C64.1, R10.2, SW2.2, U7.14 (NRST)
/MCU/OSC_32_IN: C1.1, U7.8 (PC14), Y2.1
/MCU/OSC_32_OUT: C3.1, U7.9 (PC15), Y2.2
/MCU/OSC_IN: C16.1, U7.12 (PH0), Y3.1
/MCU/OSC_OUT: C4.1, U7.13 (PH1), Y3.3
/MCU/RED_LED: D4.2 (A), U7.15 (PC0)
/MCU/VCAP1: C5.2, U7.48 (VCAP)
/MCU/VCAP2: C10.2, U7.73 (VCAP)
/MCU/VREF+: C63.1, R106.2, U7.20 (VREF+)
AUX_RX: U7.93 (PB7); also elsewhere on the board
AUX_TX: U7.92 (PB6); also elsewhere on the board
BMP_INT: U7.2 (PE3); also elsewhere on the board
BMP_MISO: U7.4 (PE5); also elsewhere on the board
BMP_MOSI: U7.5 (PE6); also elsewhere on the board
BMP_SCK: U7.1 (PE2); also elsewhere on the board
BMP_SS: U7.3 (PE4); also elsewhere on the board
Compass_I2C_SCL: U7.95 (PB8); also elsewhere on the board
Compass_I2C_SDA: U7.96 (PB9); also elsewhere on the board
Current_sense: U7.18 (PC3_C); also elsewhere on the board
ESC1: U7.39 (PE9); also elsewhere on the board
ESC2: U7.41 (PE11); also elsewhere on the board
ESC3: U7.43 (PE13); also elsewhere on the board
ESC4: U7.44 (PE14); also elsewhere on the board
GND: C1.2, C3.2, C4.2, C5.1, C6.2, C10.1, C16.2, C17.2, C18.2, C32.2, C36.2, C37.2, C38.2, C41.2, C43.2, C44.2, C53.2, C56.2, C59.2, C63.2, C64.2, R14.2, R83.2, SW1.1 (A), SW2.1, U7.10 (VSS), U7.19 (VSSA), U7.26 (VSS), U7.49 (VSS), U7.74 (VSS), U7.99 (VSS), Y3.2, Y3.4; also elsewhere on the board
GPIO1: U7.85 (PD4); also elsewhere on the board
GPIO2: U7.86 (PD5); also elsewhere on the board
GPIO3: U7.87 (PD6); also elsewhere on the board
GPS_UART_RX: U7.97 (PE0); also elsewhere on the board
GPS_UART_TX: U7.98 (PE1); also elsewhere on the board
ICM86_INT: U7.28 (PA4); also elsewhere on the board
ICM86_MISO: U7.30 (PA6); also elsewhere on the board
ICM86_MOSI: U7.31 (PA7); also elsewhere on the board
ICM86_SCLK: U7.29 (PA5); also elsewhere on the board
ICM86_SS: U7.32 (PC4); also elsewhere on the board
ICM88_INT: U7.55 (PD8); also elsewhere on the board
ICM88_MISO: U7.53 (PB14); also elsewhere on the board
ICM88_MOSI: U7.54 (PB15); also elsewhere on the board
ICM88_SCK: U7.52 (PB13); also elsewhere on the board
ICM88_SS: U7.51 (PB12); also elsewhere on the board
Lidar_SCL: U7.59 (PD12); also elsewhere on the board
Lidar_SDA: U7.60 (PD13); also elsewhere on the board
MS_SPI_CLK: U7.89 (PB3); also elsewhere on the board
MS_SPI_MISO: U7.90 (PB4); also elsewhere on the board
MS_SPI_MOSI: U7.91 (PB5); also elsewhere on the board
MS_SPI_SS: U7.88 (PD7); also elsewhere on the board
unnamed: BZ1.1 (+), D7.1 (K), R1.2
unnamed: BZ1.2 (-), D7.2 (A), Q1.3 (C)
unnamed: D1.1 (K), D5.2 (A)
unnamed: D4.1 (K), R83.1
unnamed: D5.1 (K), R1.1
unnamed: D6.1 (K), R14.1
unnamed: Q1.1 (B), R84.1
unnamed: C59.1, R15.2, SW1.2 (B)
Pitot_I2C_SCL: U7.46 (PB10); also elsewhere on the board
Pitot_I2C_SDA: U7.47 (PB11); also elsewhere on the board
RF_CTS: U7.22 (PA0); also elsewhere on the board
RF_RTS: U7.23 (PA1); also elsewhere on the board
RF_RX: U7.25 (PA3); also elsewhere on the board
RF_SBUS_RX: U7.56 (PD9); also elsewhere on the board
RF_TX: U7.24 (PA2); also elsewhere on the board
SDIO_CMD: U7.83 (PD2); also elsewhere on the board
SDIO_D0: U7.65 (PC8); also elsewhere on the board
SDIO_D1: U7.66 (PC9); also elsewhere on the board
SDIO_D2: U7.78 (PC10); also elsewhere on the board
SDIO_D3: U7.79 (PC11); also elsewhere on the board
SDIO_SCK: U7.80 (PC12); also elsewhere on the board
SD_CD: U7.82 (PD1); also elsewhere on the board
SERVO1: U7.34 (PB0); also elsewhere on the board
SERVO2: U7.35 (PB1); also elsewhere on the board
SERVO3: U7.61 (PD14); also elsewhere on the board
SERVO4: U7.62 (PD15); also elsewhere on the board
SWDCLK: U7.76 (PA14); also elsewhere on the board
SWDIO: U7.72 (PA13); also elsewhere on the board
USB_D+: U7.71 (PA12); also elsewhere on the board
USB_D-: U7.70 (PA11); also elsewhere on the board
Voltage_sense: U7.17 (PC2_C); also elsewhere on the board

Notes on the sheet:
C1 = C2 = 2(CL - Cs) ----------------- C1 = C2 = 2(7-4) = 6pF
Max current consumption: 160mA
MCU
C1 = C2 = 2(CL - Cs) ----------------- C1 = C2 = 2(10-5) = 10pF
VDD decouple caps
LEDs
Reset Button
Vref filter
- 4 SPI - SDMMC - 3 I2C - 1 SBUS - 3 UART - SWD - 4 Dshot - 4 PWM - 2 Channel ADC
Boot switch
LSE Oscillator
Analog decouple
Buzzer
HSE Oscillator
[0] MCU

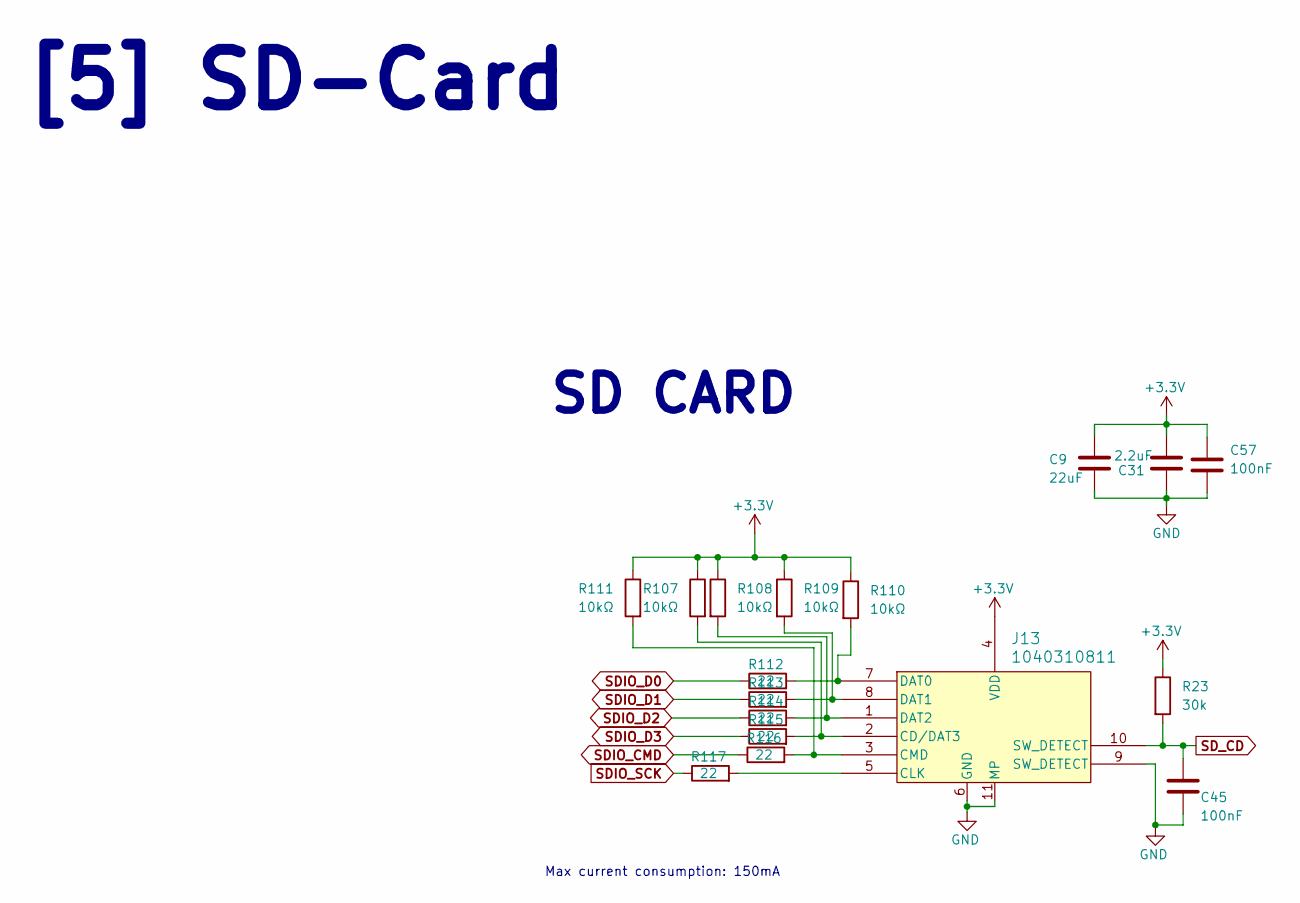
[picture p19: schematic SD-card.kicad_sch]

Parts:
C9: 22uF; C_0805_2012Metric; Part Number CL21A226KOQNNNE
C31: 2.2uF; C_0603_1608Metric; Part Number CL10B225KP8NNNC
C45, C57: 100nF; C_0402_1005Metric; Part Number GRM155R71C104KA88D
J13: 1040310811; 104031-0811_MOL; Part Number 104031-0811
R23: 30k; R_0402_1005Metric; Part Number ERJ2RKF3002X
R107, R108, R109, R110, R111: 10kΩ; R_0402_1005Metric; Part Number ERJ2RKF1002X
R112, R113, R114, R115, R116, R117: 22; R_0402_1005Metric; Part Number CQ02WGF220JTCE

Connections:
+3.3V: C9.1, C31.1, C57.1, J13.4 (VDD), R23.1, R107.1, R108.1, R109.1, R110.1, R111.1; also elsewhere on the board
GND: C9.2, C31.2, C45.2, C57.2, J13.6 (GND), J13.9 (SW_DETECT), J13.11 (MP), J13.12 (MP), J13.13 (MP), J13.14 (MP); also elsewhere on the board
unnamed: J13.2 (CD/DAT3), R107.2, R115.2
unnamed: J13.5 (CLK), R117.2
unnamed: J13.3 (CMD), R111.2, R116.2
unnamed: J13.7 (DAT0), R110.2, R112.2
unnamed: J13.8 (DAT1), R109.2, R113.2
unnamed: J13.1 (DAT2), R108.2, R114.2
SDIO_CMD: R116.1; also elsewhere on the board
SDIO_D0: R112.1; also elsewhere on the board
SDIO_D1: R113.1; also elsewhere on the board
SDIO_D2: R114.1; also elsewhere on the board
SDIO_D3: R115.1; also elsewhere on the board
SDIO_SCK: R117.1; also elsewhere on the board
SD_CD: C45.1, J13.10 (SW_DETECT), R23.2; also elsewhere on the board

Notes on the sheet:
[5] SD-Card
Max current consumption: 150mA
SD CARD

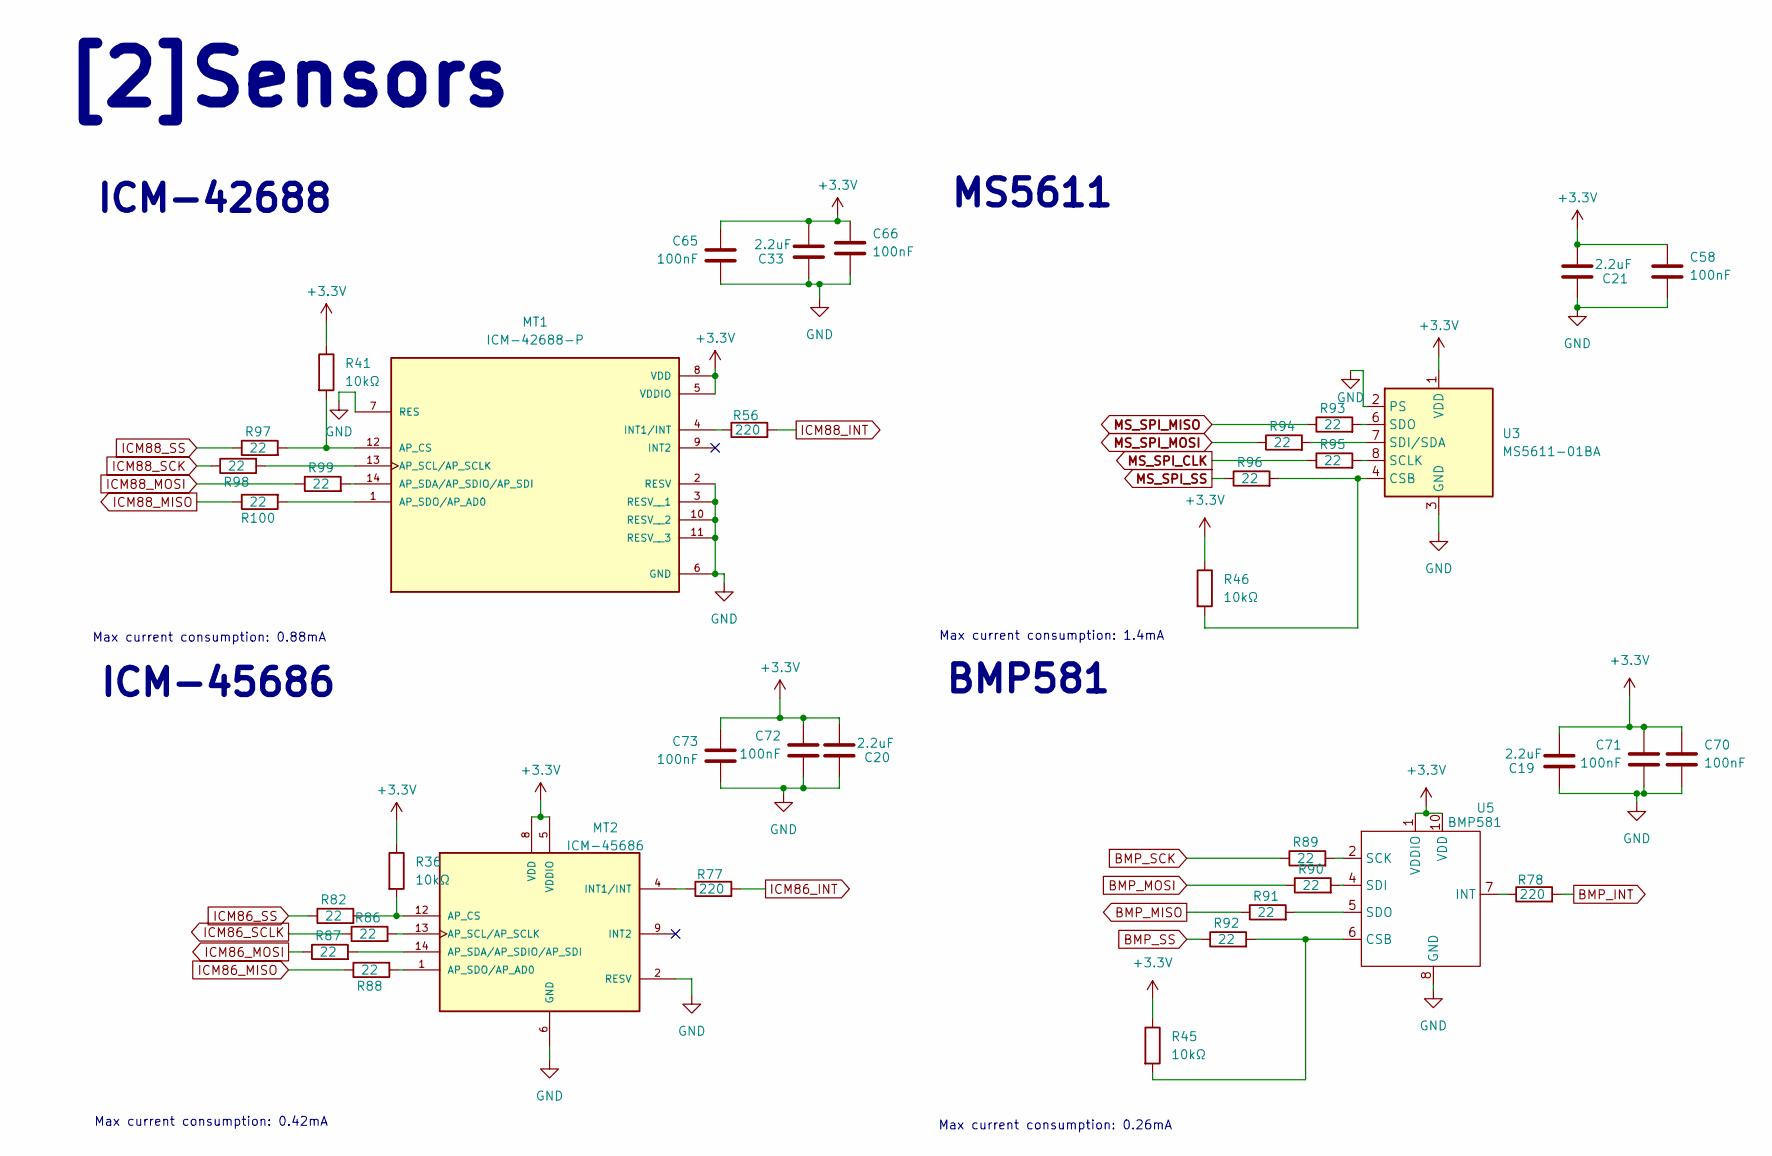
[picture p20: schematic Sensors.kicad_sch]

Parts:
C19, C20, C21, C33: 2.2uF; C_0603_1608Metric; Part Number CL10B225KP8NNNC
C58, C65, C66, C70, C71, C72, C73: 100nF; C_0402_1005Metric; Part Number GRM155R71C104KA88D
MT1: ICM-42688-P; LGA14_2P5X3X0P91_TDK-L; PARTREV 1.1
MT2: ICM-45686; LGA14_2P5X3X0P91_TDK-L; PARTREV 1.1
R36, R41, R45, R46: 10kΩ; R_0402_1005Metric; Part Number ERJ2RKF1002X
R56, R77, R78: 220; R_0402_1005Metric; Part Number ERJ2RKF2200X
R82, R86, R87, R88, R89, R90, R91, R92, R93, R94, R95, R96, R97, R98, R99, R100: 22; R_0402_1005Metric; Part Number CQ02WGF220JTCE
U3: MS5611-01BA; LGA-8_3x5mm_P1.25mm
U5: BMP581; Part Number BMP581

Connections:
+3.3V: C19.1, C20.1, C21.1, C33.1, C58.1, C65.1, C66.1, C70.1, C71.1, C72.1, C73.1, MT1.5 (VDDIO), MT1.8 (VDD), MT2.5 (VDDIO), MT2.8 (VDD), R36.1, R41.1, R45.1, R46.1, U3.1 (VDD), U5.1 (VDDIO), U5.10 (VDD); also elsewhere on the board
BMP_INT: R78.2; also elsewhere on the board
BMP_MISO: R91.1; also elsewhere on the board
BMP_MOSI: R90.1; also elsewhere on the board
BMP_SCK: R89.1; also elsewhere on the board
BMP_SS: R92.1; also elsewhere on the board
GND: C19.2, C20.2, C21.2, C33.2, C58.2, C65.2, C66.2, C70.2, C71.2, C72.2, C73.2, MT1.2 (RESV), MT1.3 (RESV__1), MT1.6 (GND), MT1.7 (RES), MT1.10 (RESV__2), MT1.11 (RESV__3), MT2.2 (RESV), MT2.3 (RESV__1), MT2.6 (GND), MT2.7 (RESV), MT2.10 (RESV__2), MT2.11 (RESV__3), U3.2 (PS), U3.3 (GND), U5.3 (GND), U5.8 (GND), U5.9 (GND); also elsewhere on the board
ICM86_INT: R77.2; also elsewhere on the board
ICM86_MISO: R88.1; also elsewhere on the board
ICM86_MOSI: R87.1; also elsewhere on the board
ICM86_SCLK: R86.1; also elsewhere on the board
ICM86_SS: R82.1; also elsewhere on the board
ICM88_INT: R56.2; also elsewhere on the board
ICM88_MISO: R100.1; also elsewhere on the board
ICM88_MOSI: R99.1; also elsewhere on the board
ICM88_SCK: R98.1; also elsewhere on the board
ICM88_SS: R97.1; also elsewhere on the board
MS_SPI_CLK: R95.1; also elsewhere on the board
MS_SPI_MISO: R93.1; also elsewhere on the board
MS_SPI_MOSI: R94.1; also elsewhere on the board
MS_SPI_SS: R96.1; also elsewhere on the board
unnamed: MT1.12 (AP_CS), R41.2, R97.2
unnamed: MT1.13 (AP_SCL/AP_SCLK), R98.2
unnamed: MT1.14 (AP_SDA/AP_SDIO/AP_SDI), R99.2
unnamed: MT1.1 (AP_SDO/AP_AD0), R100.2
unnamed: MT1.4 (INT1/INT), R56.1
unnamed: MT2.12 (AP_CS), R36.2, R82.2
unnamed: MT2.13 (AP_SCL/AP_SCLK), R86.2
unnamed: MT2.14 (AP_SDA/AP_SDIO/AP_SDI), R87.2
unnamed: MT2.1 (AP_SDO/AP_AD0), R88.2
unnamed: MT2.4 (INT1/INT), R77.1
unnamed: R46.2, R96.2, U3.4 (CSB), U3.5 (CSB)
unnamed: R95.2, U3.8 (SCLK)
unnamed: R94.2, U3.7 (SDI/SDA)
unnamed: R93.2, U3.6 (SDO)
unnamed: R45.2, R92.2, U5.6 (CSB)
unnamed: R78.1, U5.7 (INT)
unnamed: R89.2, U5.2 (SCK)
unnamed: R90.2, U5.4 (SDI)
unnamed: R91.2, U5.5 (SDO)

Notes on the sheet:
Max current consumption: 0.26mA
MS5611
BMP581
ICM-42688
Max current consumption: 1.4mA
Max current consumption: 0.42mA
ICM-45686
Max current consumption: 0.88mA
[2]Sensors

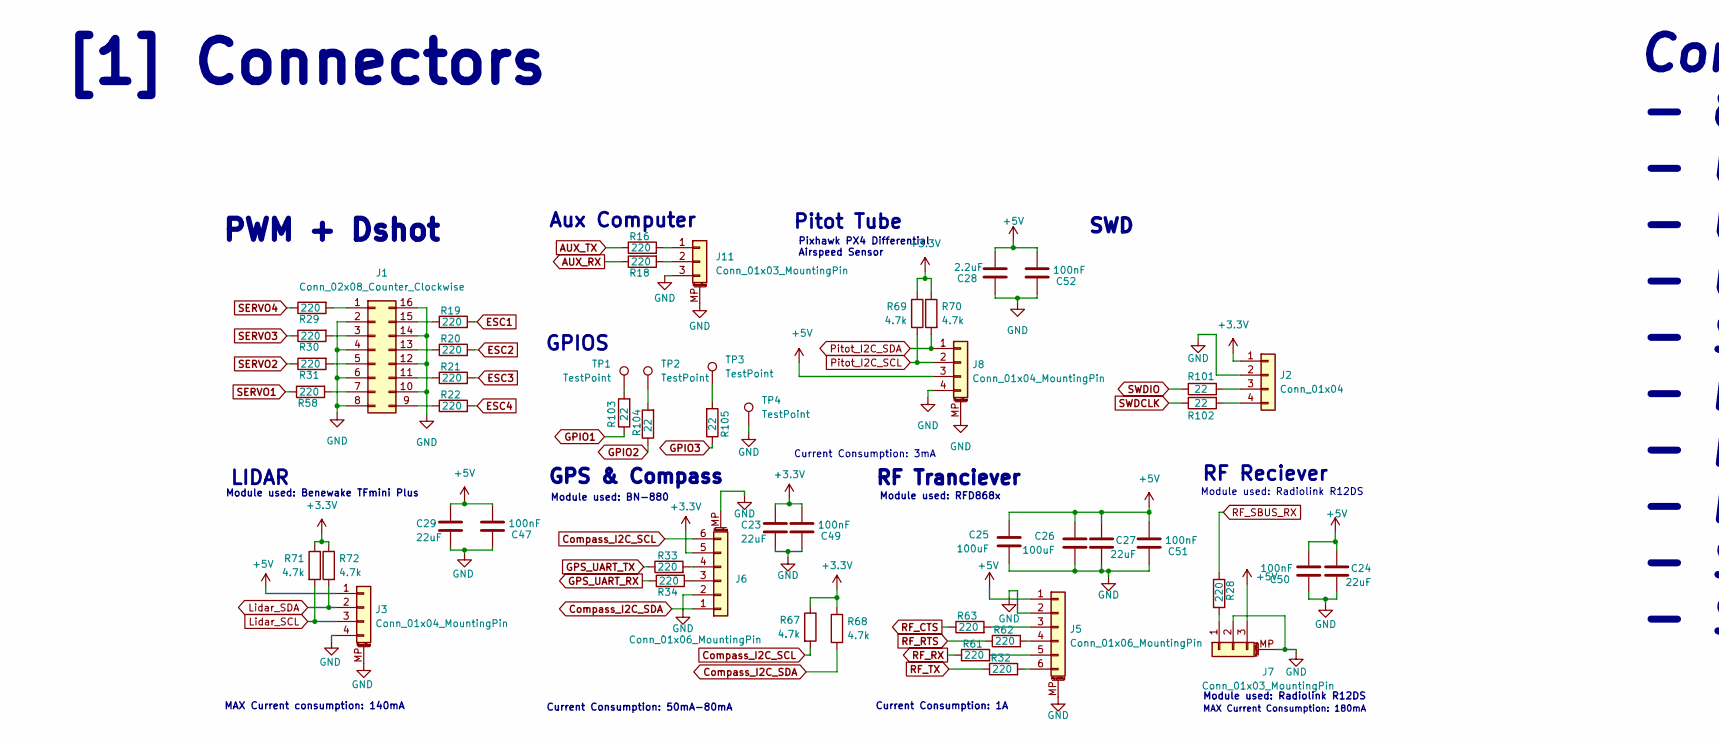
[picture p21: schematic Connectors.kicad_sch, Connectors and interface, part in row 1, column 1]

Parts:
C23, C24, C27, C29: 22uF; C_0805_2012Metric; Part Number CL21A226KOQNNNE
C25, C26: 100uF; CP_EIA-6032-20_AVX-F; Part Number 293D107X0010C2TE3
C28: 2.2uF; C_0603_1608Metric; Part Number CL10B225KP8NNNC
C47, C49, C50, C51, C52: 100nF; C_0402_1005Metric; Part Number GRM155R71C104KA88D
J1: Conn_02x08_Counter_Clockwise; PinHeader_2x08_P2.54mm_Horizontal; Part Number DS1022-2X8RF11-B
J2: Conn_01x04; PinHeader_1x04_P2.54mm_Vertical; Part Number 22-28-4046
J3, J8: Conn_01x04_MountingPin; JST_GH_SM04B-GHS-TB_1x04-1MP_P1.25mm_Horizontal; Part Number SM04B-GHS-TB(LF)(SN)
J5: Conn_01x06_MountingPin; Molex_CLIK-Mate_502494-0670_1x06-1MP_P2.00mm_Horizontal; Part Number 502494-0670
J6: Conn_01x06_MountingPin; JST_GH_SM06B-GHS-TB_1x06-1MP_P1.25mm_Horizontal; Part Number SM06B-GHS-TB
J7, J11: Conn_01x03_MountingPin; JST_GH_SM03B-GHS-TB_1x03-1MP_P1.25mm_Horizontal; Part Number SM03B-GHS-TB(LF)(SN)
R16, R18, R19, R20, R21, R22, R28, R29, R30, R31, R32, R33, R34, R58, R61, R62, R63: 220; R_0402_1005Metric; Part Number ERJ2RKF2200X
R67, R68, R69, R70, R71, R72: 4.7k; R_0402_1005Metric; Part Number ERJ2RKF4701X
R101, R102, R103, R104, R105: 22; R_0402_1005Metric; Part Number CQ02WGF220JTCE
TP1, TP2, TP3, TP4: TestPoint; TestPoint_Pad_1.0x1.0mm

Connections:
+3.3V: C23.1, C49.1, J2.1, J6.5, R67.1, R68.1, R69.1, R70.1, R71.1, R72.1; also elsewhere on the board
+5V: C24.1, C25.1, C26.1, C27.1, C28.1, C29.1, C47.1, C50.1, C51.1, C52.1, J3.1, J5.1, J7.3, J8.3; also elsewhere on the board
AUX_RX: R18.1; also elsewhere on the board
AUX_TX: R16.1; also elsewhere on the board
Compass_I2C_SCL: J6.6, R67.2; also elsewhere on the board
Compass_I2C_SDA: J6.1, R68.2; also elsewhere on the board
ESC1: R19.2; also elsewhere on the board
ESC2: R20.2; also elsewhere on the board
ESC3: R21.2; also elsewhere on the board
ESC4: R22.2; also elsewhere on the board
GND: C23.2, C24.2, C25.2, C26.2, C27.2, C28.2, C29.2, C47.2, C49.2, C50.2, C51.2, C52.2, J1.2, J1.4, J1.6, J1.8, J1.10, J1.12, J1.14, J1.16, J2.2, J3.4, J3.MP (MountPin), J5.2, J5.MP (MountPin), J6.2, J6.MP (MountPin), J7.2, J7.MP (MountPin), J8.4, J8.MP (MountPin), J11.3, J11.MP (MountPin), TP4.1 (1_1); also elsewhere on the board
GPIO1: R103.1; also elsewhere on the board
GPIO2: R104.1; also elsewhere on the board
GPIO3: R105.1; also elsewhere on the board
GPS_UART_RX: R34.1; also elsewhere on the board
GPS_UART_TX: R33.1; also elsewhere on the board
Lidar_SCL: J3.3, R71.2; also elsewhere on the board
Lidar_SDA: J3.2, R72.2; also elsewhere on the board
unnamed: J1.1, R29.2
unnamed: J1.3, R30.2
unnamed: J1.5, R31.2
unnamed: J1.7, R58.2
unnamed: J1.9, R22.1
unnamed: J1.11, R21.1
unnamed: J1.13, R20.1
unnamed: J1.15, R19.1
unnamed: J2.3, R101.2
unnamed: J2.4, R102.2
unnamed: J5.3, R63.2
unnamed: J5.4, R62.2
unnamed: J5.5, R61.2
unnamed: J5.6, R32.2
unnamed: J6.3, R34.2
unnamed: J6.4, R33.2
unnamed: J7.1, R28.2
unnamed: J11.1, R16.2
unnamed: J11.2, R18.2
unnamed: R103.2, TP1.1 (1_1)
unnamed: R104.2, TP2.1 (1_1)
unnamed: R105.2, TP3.1 (1_1)
Pitot_I2C_SCL: J8.2, R69.2; also elsewhere on the board
Pitot_I2C_SDA: J8.1, R70.2; also elsewhere on the board
RF_CTS: R63.1; also elsewhere on the board
RF_RTS: R62.1; also elsewhere on the board
RF_RX: R61.1; also elsewhere on the board
RF_SBUS_RX: R28.1; also elsewhere on the board
RF_TX: R32.1; also elsewhere on the board
SERVO1: R58.1; also elsewhere on the board
SERVO2: R31.1; also elsewhere on the board
SERVO3: R30.1; also elsewhere on the board
SERVO4: R29.1; also elsewhere on the board
SWDCLK: R102.1; also elsewhere on the board
SWDIO: R101.1; also elsewhere on the board

Notes on the sheet:
MAX Current consumption: 140mA
RF Reciever
Current Consumption: 50mA-80mA
Module used: Radiolink R12DS
LIDAR
Module used: BN-880
[1] Connectors
Current Consumption: 1A
Connections: - 8 PWM for ESCs and Servo motors - UART for GPS with a manetometer - UART for RF tranciever to communicate with GCS - UART for Auxiliary computer - SBUS (UART Reciever) for RF Reciever - I2C for pitot tube - I2C for Compass - I2C for Lidar - SWD - SDMCC for SD card
MAX Current Consumption: 180mA
Module used: Benewake TFmini Plus
Module used: RFD868x
SWD
RF Tranciever
Pixhawk PX4 Differential Airspeed Sensor
Current Consumption: 3mA
Pitot Tube
Aux Computer
GPS & Compass
GPIOS
PWM + Dshot
