karamakil08/Ahrar-Flight-Controller/Ahrar Flight Controller/Ahrar Flight Controller.kicad_pcb

## KiCad design Ahrar Flight Controller/Ahrar Flight Controller.kicad_pcb (continued)

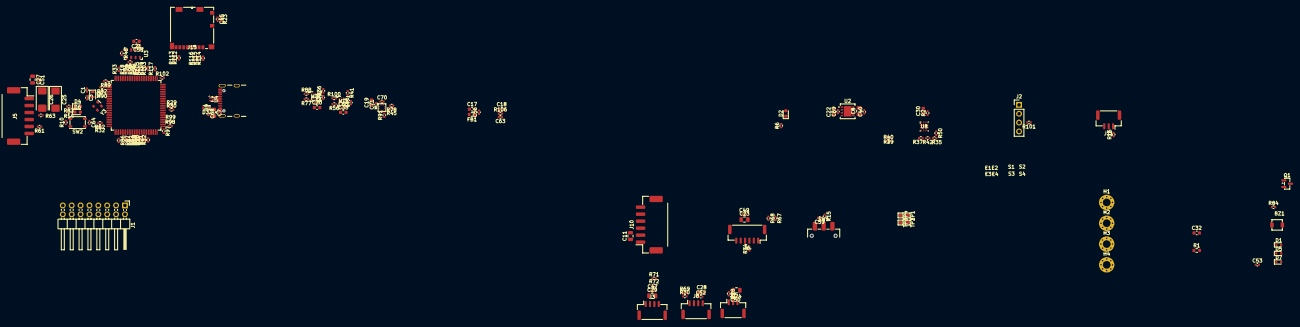
[picture p22: board Ahrar Flight Controller.kicad_pcb from above]

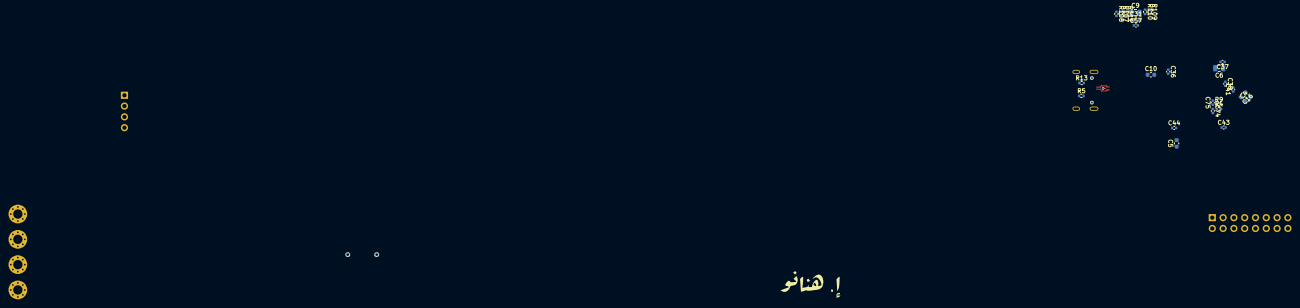
[picture p23: board Ahrar Flight Controller.kicad_pcb from below]

Board: 4 copper layers, 182 parts (26 on the bottom side), 142 nets.
