karamakil08/Ahrar-Flight-Controller/Firmware/THE FINALE/THE FINALE.ioc

Mcu.UserName=STM32H743VITx
PA0.GPIO_Label=RF_CTS
PA0.Signal=USART2_CTS
PA1.GPIO_Label=RF_RTS
PA1.Signal=USART2_RTS
PA11.Signal=USB_OTG_FS_DM
PA12.Signal=USB_OTG_FS_DP
PA2.GPIO_Label=RF_TX
PA2.Signal=USART2_TX
PA3.GPIO_Label=RF_RX
PA3.Signal=USART2_RX
PA4.GPIO_Label=ICM86_INT
PA4.Signal=GPIO_Input
PA5.GPIO_Label=ICM86_SCK
PA5.Signal=SPI1_SCK
PA6.GPIO_Label=ICM86_MISO
PA6.Signal=SPI1_MISO
PA7.GPIO_Label=ICM86_MOSI
PA7.Signal=SPI1_MOSI
PB0.GPIO_Label=SERVO1
PB0.Signal=S_TIM3_CH3
PB1.GPIO_Label=SERVO2
PB1.Signal=S_TIM3_CH4
PB10.GPIO_Label=Pitot_SCL
PB10.Signal=I2C2_SCL
PB11.GPIO_Label=Pitot_SDA
PB11.Signal=I2C2_SDA
PB12.GPIO_Label=ICM88_SS
PB12.Signal=GPIO_Output
PB13.GPIO_Label=ICM88_SCK
PB13.Signal=SPI2_SCK
PB14.GPIO_Label=ICM88_MISO
PB14.Signal=SPI2_MISO
PB15.GPIO_Label=ICM88_MOSI
PB15.Signal=SPI2_MOSI
PB5.GPIO_Label=MS_MOSI
PB5.Signal=SPI3_MOSI
PB6.GPIO_Label=AUX_TX
PB6.Signal=USART1_TX
PB7.GPIO_Label=AUX_RX
PB7.Signal=USART1_RX
PB8.GPIO_Label=Compass_SCL
PB8.Signal=I2C1_SCL
PB9.GPIO_Label=Compass_SDA
PB9.Signal=I2C1_SDA
PC0.GPIO_Label=RED_LED
PC0.Signal=GPIO_Output
PC1.GPIO_Label=BLUE_LED
PC1.Signal=GPIO_Output
PC10.Signal=SDMMC1_D2
PC11.Signal=SDMMC1_D3
PC12.Signal=SDMMC1_CK
PC2_C.GPIO_Label=Voltage_Sense
PC2_C.Signal=GPIO_Analog
PC3_C.GPIO_Label=Current_Sense
PC3_C.Signal=GPIO_Analog
PC4.GPIO_Label=ICM86_SS
PC4.Signal=GPIO_Output
PC6.GPIO_Label=Buzzer
PC6.Signal=S_TIM8_CH1
PC8.Signal=SDMMC1_D0
PC9.Signal=SDMMC1_D1
PD1.GPIO_Label=SD_CD
PD1.Signal=GPIO_Input
PD12.GPIO_Label=LIDAR_SCL
PD12.Signal=I2C4_SCL
PD13.GPIO_Label=LIDAR_SDA
PD13.Signal=I2C4_SDA
PD14.GPIO_Label=SERVO3
PD14.Signal=S_TIM4_CH3
PD15.GPIO_Label=SERVO4
PD15.Signal=S_TIM4_CH4
PD2.Signal=SDMMC1_CMD
PD4.GPIO_Label=GPIO1
PD4.Signal=GPIO_Output
PD5.GPIO_Label=GPIO2
PD5.Signal=GPIO_Output
PD6.GPIO_Label=GPIO3
PD6.Signal=GPIO_Output
PD7.GPIO_Label=MS_SS
PD7.Signal=GPIO_Output
PD8.GPIO_Label=ICM88_INT
PD8.Signal=GPIO_Input
PD9.GPIO_Label=SBUS_RX
PD9.Signal=USART3_RX
PE0.GPIO_Label=GPS_RX
PE0.Signal=UART8_RX
PE1.GPIO_Label=GPS_TX
PE1.Signal=UART8_TX
PE11.GPIO_Label=ESC2
PE11.Signal=S_TIM1_CH2
PE13.GPIO_Label=ESC3
PE13.Signal=S_TIM1_CH3
PE14.GPIO_Label=ESC4
PE14.Signal=S_TIM1_CH4
PE2.GPIO_Label=BMP_SCK
PE2.Signal=SPI4_SCK
PE3.GPIO_Label=BMP_INT
PE3.Signal=GPIO_Input
PE4.GPIO_Label=BMP_SS
PE4.Signal=GPIO_Output
PE5.GPIO_Label=BMP_MISO
PE5.Signal=SPI4_MISO
PE6.GPIO_Label=BMP_MOSI
PE6.Signal=SPI4_MOSI
PE9.GPIO_Label=ESC1
PE9.Signal=S_TIM1_CH1
