karamakil08/Ahrar-Flight-Controller/(commit log)

2026-07-04 This is sparta
    [Ahrar Flight Controller.csv, Ahrar Flight Controller.kicad_pcb, Ahrar Flight Controller.kicad_sch, Connectors.kicad_sch, MCU.kicad_sch, Power.kicad_sch, Sensors.kicad_sch]
2026-07-21 Adding previous files
    [Ahrar Flight Controller.kicad_sch, Connectors.kicad_sch, MCU.kicad_sch, Power.kicad_sch, Sensors.kicad_sch]
